menonkrishna57/model-car-capstone/docs/reports/screenshots/screenshot_intermediate_cv_steps.jpg

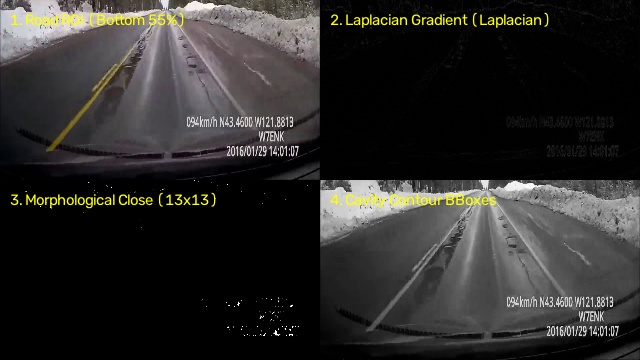
docs/reports/screenshots/screenshot_intermediate_cv_steps.jpg
