menonkrishna57/model-car-capstone/docs/reports/screenshots/slide07_pothole_corridor_frame.jpg

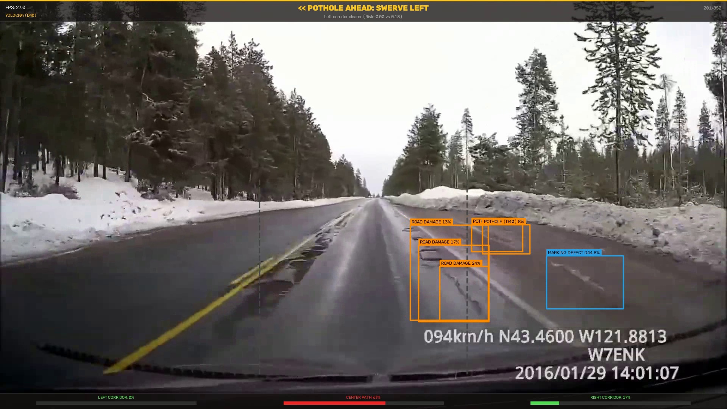
docs/reports/screenshots/slide07_pothole_corridor_frame.jpg
