menonkrishna57/model-car-capstone/docs/architecture.md

# System Architecture — Autonomous Follow-Me and Obstacle-Avoidant RC Vehicle

**Status:** APPROVED / PRODUCTION BASELINE (Architecture v2 — Verified Hardware Baseline)  
**Last Updated:** 2026-10-11  
**Target Hardware:** Raspberry Pi 5 (8GB) + Arduino Uno R3 (ATmega328P)  
**Primary Repositories:** `model-car-capstone` / `MentorPi`  
**Active Branch:** `pothole-detection` / `main`

---

## Executive Summary

This document specifies the canonical system architecture for the autonomous, two-layer robotic model car developed for the B.Tech Capstone Project. The vehicle operates in two distinct operational regimes:
1. **Autonomous Navigation Mode:** Cruising, dynamic obstacle avoidance, and camera-based negative obstacle (pothole/cavity) evasion.
2. **Follow-Me Mode:** Target-locking, real-time person tracking via visual servoing, HSV appearance-based re-identification, and reflexive collision prevention.

To overcome the fundamental failure modes of monolithic, single-board robotics systems—namely Linux kernel preemption, software GPIO PWM jitter, and brownout vulnerability under heavy deep learning workloads—the architecture strictly partitions tasks into a **Cognitive High-Level Brain** (Raspberry Pi 5) and a **Reflexive Hard Real-Time Spine** (Arduino Uno ATmega328P).

```
+---------------------------------------------------------------------------------------+
|                                    SYSTEM TOPOLOGY                                    |
+---------------------------------------------------------------------------------------+
|                                                                                       |
|   +----------------------------------+             +------------------------------+   |
|   |   Raspberry Pi 5 (High-Level)    |             |  Arduino Uno (Real-Time)     |   |
|   |----------------------------------|             |------------------------------|   |
|   | • CSI Camera (OV5647 5MP)        |  USB-Serial | • Hardware Timer0 PWM (D5/D6)|   |
|   | • YOLOv10n (NCNN NMS-Free)       | 115200 Baud | • 3-Tier Priority FSM        |   |
|   | • RDD2022 Pothole YOLO / CV      |    8-N-1    | • 2x HC-SR04P (D7/13, D12/4) |   |
|   | • HSV Appearance Re-ID Tracker   |<----------->| • L298N Skid-Steer (Inverted)|   |
|   | • Discrete PID Steering Engine   |             | • Auto-Brake (<25cm Reflex)  |   |
|   |                                  |             | • Serial Halt ('s'/'g' Pause)|   |
|   +----------------------------------+             +------------------------------+   |
|                    ^                                               ^                  |
|                    | Dedicated 5.1V/5A                             | 7.4V (2S 18650)  |
|   +----------------------------------+             +---------------+--------------+   |
|   | boAt EnergyShroom PB400 Battery  |             | 2S 18650 Li-Ion + Common GND |   |
|   +----------------------------------+             +------------------------------+   |
|                                                                                       |
+---------------------------------------------------------------------------------------+
```

---

## 1. Architectural Philosophy & The Two-Layer Split

### 1.1 The Single-Board Failure Mode (The Linux OS Problem)
Conventional edge AI mobile robots (e.g., NVIDIA JetBot, DonkeyCar) run both high-level neural inference and low-level motor pulsing on a single Linux system-on-chip. This design suffers from three critical failure modes:
1. **Software PWM Timing Jitter:** The Linux Completely Fair Scheduler (CFS) provides no deterministic real-time execution guarantees. Under heavy neural inference (such as YOLOv10 or MobileNet), CPU interrupt latency surges from $<50\,\mu\text{s}$ to $>30\,\text{ms}$. Pulses generated across software GPIO pins jitter violently, causing motor shudder, differential wheel slip, and erratic skid-steer heading errors.
2. **Safety Reflex Preemption:** When an obstacle appears within $15\,\text{cm}$, a single-board architecture must process the image frame, run bounding box prediction, score threat zones, and issue GPIO signals. This pipeline introduces $60\text{–}120\,\text{ms}$ of latency. At a cruising speed of $1.5\,\text{m/s}$, the chassis moves $18\,\text{cm}$ before braking initiates, guaranteeing a physical collision.
3. **OS Crash / Hang Vulnerability:** In the event of a Linux kernel panic, out-of-memory (OOM) freeze, or Python process crash, GPIO pins latch in their last active logic state. A car driving forward will continue driving at full speed into walls, stairs, or human bystanders.

### 1.2 The Two-Layer Solution
Our architecture enforces strict physical and functional isolation:

| Engineering Parameter | Single-Board Architecture (JetBot / DonkeyCar) | Our Two-Layer Architecture (Pi 5 + Arduino Uno) |
|---|---|---|
| **Motor PWM Generation** | Software GPIO (jittery under load, $\pm 25\,\text{ms}$) | Hardware 8-bit Timer0/Timer1/Timer2 (rock-solid, $< 4\,\mu\text{s}$) |
| **Ultrasonic Echo Timing** | User-space polling (unreliable, pulse truncation) | Dedicated microcontroller `pulseIn()` timing ($1\,\mu\text{s}$ precision) |
| **Emergency Reflex Loop** | Soft real-time (60–120 ms round trip) | Hard real-time Tier 2 reflex ($< 10\,\text{ms}$ autonomous trigger) |
| **Crash Protection** | Motors latch at previous state on crash | Hardware Watchdog halts all motors if Pi heartbeat lost ($> 5000\,\text{ms}$, configurable) |
| **Electrical Stability** | Motor back-EMF couples directly into SBC power rail | Dual-rail supplies with common signal ground eliminate brownout resets |
| **BOM Cost** | $\$250\text{–}\$350$ (expensive single boards / carrier kits) | $\sim \$120\text{–}\$150$ (accessible, modular academic components) |

---

## 2. Hardware Architecture & Electrical Design

### 2.1 Complete Pin Mapping Matrix
> **Hardware Status: ARCHITECTURE V2 VERIFIED & BENCH TESTED (2026-10-11).**  
> Complete physical pin tracing, ultrasonic transceiver mapping, motor polarity inversion correction, and TT motor PWM torque compensation have been verified on the physical chassis.

Authoritative pin definitions are maintained in [`arduino/lib/pins.h`](../arduino/lib/pins.h):

| Arduino Uno Pin | Direction | Assigned Function | Connected Hardware Subsystem | Hardware Timer / Characteristics |
|:---:|:---:|---|---|---|
| **D2** | UNCONNECTED | *Reserved / Unused* | Physically Empty | Available for wheel encoder / `INT0` |
| **D3** | UNCONNECTED | *Reserved / Unused* | Physically Empty | Available for wheel encoder / `INT1` |
| **D4** | INPUT | **Right Ultrasonic Echo** | HC-SR04P Front-Right Sensor | $1\,\mu\text{s}$ pulse timing input (`pulseIn`) |
| **D5** | OUTPUT | **ENA (Left Motor PWM)** | L298N Dual H-Bridge Channel A | **Timer0 (OC0B)** — 8-bit PWM (0–255, 980 Hz) |
| **D6** | OUTPUT | **ENB (Right Motor PWM)** | L298N Dual H-Bridge Channel B | **Timer0 (OC0A)** — 8-bit PWM (0–255, 980 Hz) |
| **D7** | OUTPUT | **Left Ultrasonic Trigger** | HC-SR04P Front-Left Sensor | $10\,\mu\text{s}$ digital trigger pulse output |
| **D8** | OUTPUT | **Motor IN1 (Left Dir 1)** | L298N Dual H-Bridge Channel A | Direction bit 1 (Firmware inverted) |
| **D9** | OUTPUT | **Motor IN2 (Left Dir 2)** | L298N Dual H-Bridge Channel A | Direction bit 2 (Firmware inverted) |
| **D10** | OUTPUT | **Motor IN3 (Right Dir 1)**| L298N Dual H-Bridge Channel B | Direction bit 1 (Firmware inverted) |
| **D11** | OUTPUT | **Motor IN4 (Right Dir 2)**| L298N Dual H-Bridge Channel B | Direction bit 2 (Firmware inverted) |
| **D12** | OUTPUT | **Right Ultrasonic Trigger**| HC-SR04P Front-Right Sensor | $10\,\mu\text{s}$ digital trigger pulse output |
| **D13** | INPUT | **Left Ultrasonic Echo** | HC-SR04P Front-Left Sensor | $1\,\mu\text{s}$ pulse timing (Uno 'L' LED flicker is purely cosmetic) |

#### 2.1.1 The Ultrasonic Pin Resolution & Phantom IR Removal
Initial documentation and legacy sketch comments incorrectly assumed pins D2 and D3 were connected to digital IR obstacle sensors, while reversing ultrasonic sensor channel mappings. Physical signal tracing and diagnostic bench testing confirmed:
1. **Pins D2 and D3 are physically empty** on the chassis. No IR sensors are installed on the chassis; D2 and D3 are designated as unreserved inputs, preserving them for future quadrature wheel encoders or external hardware interrupts.
2. The real physical pin routing is verified as:
   * **Left Ultrasonic Sensor:** Trigger = **D7**, Echo = **D13**
   * **Right Ultrasonic Sensor:** Trigger = **D12**, Echo = **D4**
3. **Pin D13 Characteristics:** On the Arduino Uno, pin D13 is internally tied via an op-amp/resistor circuit to the onboard 'L' surface-mount LED. When the Left Ultrasonic emits an echo pulse, the LED flickers faintly. This is cosmetic only and introduces zero signal distortion or timing inaccuracy to `pulseIn()` timing.
4. Live simultaneous centimeter distance telemetry streaming was bench-validated from both ultrasonic transceivers at 115200 baud.

#### 2.1.2 Motor Wiring Polarity & Direction Inversion
Due to physical chassis mounting orientations, the 4WD TT gearbox DC motors were wired with inverted polarity relative to standard H-bridge logic (asserting `IN1=HIGH, IN2=LOW` drove the chassis in reverse). Under the project's strict hard constraint (borrowed lab hardware under shared ID rotation; no cutting or desoldering), physical rewiring was rejected.

This was resolved cleanly at the firmware layer via `#define INVERT_MOTOR_POLARITY true` in [`arduino/lib/pins.h`](../arduino/lib/pins.h) and `const bool INVERT_DIR = true;` in sketch files. The motor driver routines invert speed sign (`s = -s`) prior to setting `IN1`–`IN4`, ensuring all high-level forward drive commands spin the wheels forward.

#### 2.1.3 TT Motor Torque & L298N Voltage Drop Calibration
The L298N dual H-bridge motor driver employs internal bipolar Darlington transistors ($V_{CE(\text{sat})} \approx 1.8\text{–}2.0\,\text{V}$ total drop across high-side and low-side transistors). When powered by a 2S 18650 Li-Ion battery pack ($7.4\,\text{V}$ nominal, $8.4\,\text{V}$ peak), the effective motor terminal voltage is only:
$$V_{\text{motor}} = V_{\text{battery}} - V_{\text{drop}} \approx 7.4\,\text{V} - 2.0\,\text{V} = 5.4\,\text{V}$$

The legacy default PWM speed value of $120$ ($\approx 47\%$ duty cycle) delivered an effective RMS voltage of $\sim 2.5\,\text{V}$, resulting in severe motor stall under the chassis curb weight and floor friction. Torque has been systematically calibrated and empirically verified on the chassis:
* **Forward Cruising (`SPEED_FORWARD`):** PWM **`200`** ($\sim 78\%$ duty cycle, $\sim 4.2\,\text{V}$ RMS)
* **Pivot Skid-Turn (`SPEED_TURN`):** PWM **`210`** ($\sim 82\%$ duty cycle, delivers robust breakaway torque for zero-radius turns)
* **Reverse Clearance (`SPEED_REVERSE`):** PWM **`190`** ($\sim 75\%$ duty cycle)

### 2.2 Dual-Rail Power Distribution (Common Ground Reference)
To prevent inductive motor back-EMF and switching transients from triggering Raspberry Pi brownouts, the power system is partitioned into two physically isolated rails:

```
  MOTOR & ARDUINO RAIL (Common Ground)               PI 5 RAIL (Dedicated boAt PB400)
  ====================================               ====================

  +-------------------------------+                 +-----------------------------------+
  | 2S 18650 Li-Ion Battery Pack  |                 | boAt EnergyShroom PB400 Powerbank |
  |   7.4V Nominal (1500-2500mAh) |                 |   USB-C 5.1V / 5.0A Output        |
  +---------------+---------------+                 +-----------------+-----------------+
                  |                                                   |
                  |                                                   v
                  |                                 +-----------------+-----------------+
                  |                                 | Raspberry Pi 5 (8GB)              |
                  |                                 | Broadcom BCM2712 Quad-Core A76    |
                  |                                 +-----------------+-----------------+
                  |                                                   |
                  v                                                   | USB-A to USB-B
           +------+------+                                            | Serial Cable
           |    L298N    |                                            | (Data + Common GND)
           |    Motor    |<-------------------------------------------+
           |    Driver   |
           +---+----+----+
               |    |
      7.4V VMS |    | Logic 5V / Common GND
               v    v
         +-----+----+----+
         |  Arduino Uno  |
         |  ATmega328P   |
         +-------+-------+
                 |
                 v
         +-------+-------+
         | 16-Pin Berg   |
         | Strip Header  |
         +-------+-------+
                 |
         +-------+-------+
         |               |
         v               v
     4x TT DC        2x HC-SR04P
      Motors          Ultrasonics
   (Skid-Steer)      (Front Array)
```

* **Common Ground Principle:** The motor power rail (2S 18650 negative terminal, L298N GND, and Arduino GND) shares a single ground reference with the Raspberry Pi 5 exclusively through the shielded USB-Serial cable. This preserves 5V logic signal integrity while completely isolating high-current inductive motor spikes from the Pi's sensitive power rail.
* **16-Pin Berg Strip Header:** Provides organized distribution of the regulated 5V bus and ground reference:
  * Pins 1–8: Common +5V Rail (Arduino 5V output, 2x HC-SR04P VCC, L298N logic VCC, spare headers).
  * Pins 9–16: Common GND Rail (Arduino GND, 2x HC-SR04P GND, L298N logic GND, spare headers).

### 2.3 Sensor Array & Spatial Field-of-View (FOV)
The chassis mounts an overlapping multi-sensor array:

```
                          FRONT OF CHASSIS
               ______________________________________
              |                                      |
              |   [US1: Left]          [US2: Right]  |
              |   (Trig D7,            (Trig D12,    |
              |    Echo D13)            Echo D4)     |
              |      \                    /          |   US1: 15° Left Divergence
              |       \   Forward Cone   /           |   US2: 15° Right Divergence
              |        \   Overlapping  /            |   Combined Cone: ~60°
              |         \              /             |   Threshold: < 25.0 cm (Auto-Brake)
              |          \            /              |   Debounce: 2 Confirm Reads
              |           \          /               |
              |            \        /                |
              |             \      /                 |
              |               [CAM]                  |   CAM: CSI Camera (OV5647, ~54° HFOV)
              |               (CSI)                  |   (D2/D3 empty; no IR sensors)
              |                                      |
              |  [FL Wheel]          [FR Wheel]      |   Skid-Steer TT DC Motors
              |  [RL Wheel]          [RR Wheel]      |   Left Pair: ENA(D5) / IN1(D8) / IN2(D9)
              |______________________________________|   Right Pair: ENB(D6) / IN3(D10) / IN4(D11)

                          REAR OF CHASSIS
```

* **HC-SR04P Ultrasonic Transceivers (x2):** Splayed laterally by $15^\circ$ to cover corner obstacles. Effective ranging: $2\,\text{cm}$ to $300\,\text{cm}$. The reflex auto-brake threshold is calibrated at **$25.0\,\text{cm}$** (`OBSTACLE_CM = 25`) with a 2-sample consecutive debounce filter (`CONFIRM_READS = 2`) across $60\,\text{ms}$ loop cycles to suppress acoustic multipath spikes.
* **CSI Monocular Camera (OmniVision OV5647 5MP Rev 1.3):** Replaces the damaged Global Shutter camera, interfacing via a 22-pin to 15-pin FPC adapter cable. Features a $53.5^\circ$ horizontal FOV ($3.6\,\text{mm}$ focal length, $1/4''$ sensor). Mounted $12\,\text{cm}$ above the ground plane, angled downwards at $15^\circ$ pitch to cover both horizon targets and road surface ($0.3\text{–}4.0\,\text{m}$). Diagnostic testing is supported via the local low-latency MJPEG streaming utility ([`tools/stream.py`](../tools/stream.py)).
* **Sensor Blind Spot Coverage:** Horizontal ultrasonic sensors cannot detect road depressions or potholes. Conversely, monocular vision struggles with transparent glass or untextured surfaces at $<10\,\text{cm}$. The multi-modal sensor fusion completely eliminates mutual blind spots.

---

## 3. Firmware Architecture & 3-Tier Reflex State Machine

The Arduino Uno firmware executes a deterministic, non-blocking finite state machine at a calibrated loop rate. The verified diagnostic sketch ([`arduino/motor_test/dual_motor_speed_test.ino`](../arduino/motor_test/dual_motor_speed_test.ino)) and production firmware ([`arduino/point_to_point_control/point_to_point_control.ino`](../arduino/point_to_point_control/point_to_point_control.ino)) implement the 3-tier priority hierarchy:

```mermaid
stateDiagram-v2
    [*] --> STATE_IDLE : Power On / [TELEM] READY

    STATE_IDLE --> STATE_DRIVING : DRIVE cmd / 'g' Resume
    STATE_IDLE --> STATE_TURNING : TURN cmd
    STATE_IDLE --> STATE_REVERSING : REV cmd

    STATE_DRIVING --> STATE_IDLE : Timer Expires / [TELEM] DONE DRIVE
    STATE_TURNING --> STATE_IDLE : Timer Expires / [TELEM] DONE TURN
    STATE_REVERSING --> STATE_IDLE : Timer Expires / [TELEM] DONE REV

    STATE_DRIVING --> STATE_AVOIDING : US reading < 25cm (Tier 2 Reflex)
    STATE_TURNING --> STATE_AVOIDING : US reading < 25cm (Tier 2 Reflex)
    STATE_REVERSING --> STATE_AVOIDING : US reading < 25cm (Tier 2 Reflex)

    STATE_AVOIDING --> STATE_IDLE : Avoidance Sequence Done / [TELEM] DONE AVOID

    STATE_DRIVING --> STATE_PI_STOPPED : PI_STOP / Serial 's' (Tier 1 Latch)
    STATE_TURNING --> STATE_PI_STOPPED : PI_STOP / Serial 's' (Tier 1 Latch)
    STATE_REVERSING --> STATE_PI_STOPPED : PI_STOP / Serial 's' (Tier 1 Latch)
    STATE_AVOIDING --> STATE_PI_STOPPED : PI_STOP / Serial 's' (Tier 1 Latch)
    STATE_IDLE --> STATE_PI_STOPPED : PI_STOP / Serial 's' (Tier 1 Latch)

    STATE_PI_STOPPED --> STATE_IDLE : PI_GO / Serial 'g' (Latch Released)
```

### 3.1 Priority Tiers

#### Tier 1: Emergency Latches, Serial Pause & Watchdog (Absolute Highest Priority)
* **`PI_STOP` / Serial Emergency Halt (`'s'`):** Instantaneous latch. Forces `ENA=0`, `ENB=0` (`stopAll()`), and transitions to `STATE_PI_STOPPED` (or `isStopped = true`). All ongoing actions (including mid-maneuver Tier 2 avoidance) are aborted immediately. The vehicle remains locked until a valid release command is received:
  * Over USB-Serial protocol: `PI_GO` command releases the latch to `STATE_IDLE`.
  * Over interactive serial monitor: Sending `'g'` / `'G'` resumes operation.
* **Watchdog Failsafe:** The firmware monitors incoming serial timestamps. If no valid packet is received within $5000\,\text{ms}$ (`WATCHDOG_TIMEOUT_MS`), the car halts all motors and emits `[TELEM] HEARTBEAT_TIMEOUT`.
* **Command Blocking:** Any Tier 3 movement command received during `STATE_PI_STOPPED` is rejected with `[ACK] BLOCKED (PI_STOPPED)`.

#### Tier 2: Hard Real-Time Local Avoidance Reflex (Autonomous Microcontroller Loop)
Triggered autonomously whenever either front ultrasonic sensor reads $< 25.0\,\text{cm}$ (`OBSTACLE_CM = 25`) confirmed over 2 consecutive readings (`CONFIRM_READS = 2`). Operates with zero latency independent of the Raspberry Pi:
1. **Case A: Both Sensors Blocked ($dL < 25\,\text{cm}$ and $dR < 25\,\text{cm}$):**
   * **Phase 1 — Reverse (`REVERSE_MS = 400ms`):** Reverses both motors at PWM 190 (`SPEED_REVERSE`) to clear the collision zone.
   * **Phase 2 — Pivot Turn (`BOTH_TURN_MS = 450ms`):** Evaluates sensor clearance and turns toward the more open side ($dL \ge dR \rightarrow$ Turn Left; $dL < dR \rightarrow$ Turn Right) at PWM 210 (`SPEED_TURN`).
2. **Case B: Right Sensor Blocked Only ($dR < 25\,\text{cm}$):**
   * Immediately executes a fast skid-turn **Left** (`setLeft(-210)`, `setRight(210)`).
3. **Case C: Left Sensor Blocked Only ($dL < 25\,\text{cm}$):**
   * Immediately executes a fast skid-turn **Right** (`setLeft(210)`, `setRight(-210)`).
4. **Case D: Path Clear ($dL \ge 25\,\text{cm}$ and $dR \ge 25\,\text{cm}$):**
   * Drives forward at calibrated speed PWM 200 (`SPEED_FORWARD`).
5. **Phase 3 — Forward Resume & Cooldown:** Resumes forward cruising. Cooldown period ($500\,\text{ms}$) suppresses re-triggering during initial acceleration.
6. **`PI_AVOID` Hint Override:** If the Pi previously provided an avoidance hint (`PI_AVOID LEFT` or `PI_AVOID RIGHT`), that direction strictly overrides the local decision for both-blocked conditions.

#### Tier 3: High-Level Navigation (Supervised by Raspberry Pi)
Executes timed movement primitives calibrated for the 4WD skid-steer chassis:
* `DRIVE <speed> <duration_ms>` (Default cruising speed: PWM 200)
* `REV <speed> <duration_ms>` (Default reverse speed: PWM 190)
* `TURN <angle_deg> <speed>` (Negative angle = Left, Positive angle = Right; speed: PWM 210)
* `STOP` (Non-latched immediate halt to `STATE_IDLE`)

---

## 4. Perception & Computer Vision Architecture

The perception pipeline running on the Raspberry Pi 5 combines deep neural detection, a classical computer vision fallback for road cavities, and an appearance-based person tracker.

```mermaid
graph TD
    CAM["CSI Camera Ingest<br/>(640x480 @ 30 FPS)"] --> PRE["Preprocessing & ROI Extraction<br/>(Bottom 55% Road Plane)"]

    PRE --> YOLO["YOLOv10n (Tencent NCNN)<br/>Positive Obstacles (Cars, People)"]
    PRE --> POTHOLE["RDD2022 Custom YOLO / Classical CV<br/>Negative Obstacles (Potholes, Cracks)"]

    YOLO --> MERGE["Detection Fusion & Zone Spatial Corridors"]
    POTHOLE --> MERGE

    MERGE --> ZONE["Zone Hazard Scorer<br/>(Left, Center, Right)"]
    ZONE --> DEC["Decision Arbiter Matrix"]

    DEC -->|"EMERGENCY DANGER"| PISTOP["PI_STOP (Latch Car)"]
    DEC -->|"DIRECTIONAL SWERVE"| SWERVE["PI_AVOID + Timed TURN"]
    DEC -->|"CLEAR PATH"| FOLLOW["Follow-Me Visual Servoing"]

    FOLLOW --> KCF["KCF Spatial Tracker"]
    FOLLOW --> HSV["HSV Torso Appearance Re-ID"]
    KCF --> PID["Discrete PID Controller"]
    PID --> NAV["Serial Command Stream<br/>(DRIVE / TURN to Arduino)"]
```

### 4.1 Positive Obstacle Detection: YOLOv10n under Tencent NCNN
* **Architecture:** YOLOv10n eliminates the Non-Maximum Suppression (NMS) post-processing bottleneck by incorporating dual-label assignments during training.
* **Inference Engine:** Tencent NCNN framework with ARM Cortex-A76 NEON FP16 vectorization.
* **Target Classes:** Person (Class 0), Bicycle (1), Car (2), Motorcycle (3), Bus (5), Truck (7).
* **Latency Profile:** $\sim 22\text{–}26\,\text{ms}$ on physical Pi 5 hardware (enabling sustained 30+ FPS pipelines).

### 4.2 Negative Obstacle & Pothole Detection: Dual-Path Engine
Negative obstacles are depressions in the road plane that cannot reflect horizontal acoustic waves. Our system provides two complementary detection layers:

#### Path A: Custom RDD2022 YOLOv10n Deep Model (`pothole_detection/`)
* **Training Dataset:** Road Damage Dataset 2022 (RDD2022 India Sub-dataset, Class D40 Pothole).
* **Weights:** [`pothole_detection/best.pt`](../pothole_detection/best.pt) and [`pothole_detection/rdd2022_yolov8n.pt`](../pothole_detection/rdd2022_yolov8n.pt).
* **Dynamic Corridor & Directional Swerve Module:** Implemented in [`pothole_detection/run_detection.py`](../pothole_detection/run_detection.py):
  * Trapezoidal Perspective ROI isolates the active driving corridor.
  * Zone partitioning: Left Zone ($< 33\%$), Center Danger Corridor ($33\%\text{–}67\%$), Right Zone ($> 67\%$).
  * Automated swerve trajectory selection (`SWERVE_LEFT`, `SWERVE_RIGHT`, `EMERGENCY_STOP`).

#### Path B: Classical Computer Vision Fallback (`cv_detect_potholes`)
Implemented in [`car/perception/detector.py`](../car/perception/detector.py) and [`pothole_detection/negative_obstacle_detection/detector.py`](../pothole_detection/negative_obstacle_detection/detector.py). Runs in $<4\,\text{ms}$ with zero GPU/NPU dependency:
1. **ROI Cropping:** Extracts bottom 55% of the frame (`roi_y = int(h * 0.45)`).
2. **Gaussian Pre-Filtering:** $5\times 5$ Gaussian kernel suppresses high-frequency asphalt noise.
3. **Laplacian Edge Extraction:** Computes second-order spatial derivatives (`cv2.Laplacian(blur, cv2.CV_64F)`). Sharp intensity changes at cavity boundaries yield high response magnitudes.
4. **Morphological Elliptical Structuring:** Applies morphological closing followed by opening with a $13\times 13$ elliptical structuring element (`cv2.MORPH_ELLIPSE`) to solidify cavity regions while rejecting linear surface cracks.
5. **Contour Geometry Screening:**
   * Reject if $\text{Area} < 900\,\text{px}$ (small surface debris).
   * Reject if $\text{Area} > 0.25 \times \text{ROI Area}$ (broad shadows or lighting gradients).
   * Reject if aspect ratio $\text{Width}/\text{Height} \notin [0.25, 5.0]$.

### 4.3 Hazard Zone Danger Scoring
In [`car/perception/avoidance.py`](../car/perception/avoidance.py), bounding boxes are transformed into localized danger scores:

$$\text{Danger} = \text{Confidence} \times W \times \left(0.4 + \min\left(\frac{\text{Area}_{\text{box}}}{\text{Area}_{\text{frame}}}, 0.5\right)\right)$$

* $W = 1.0$ for standard positive obstacles.
* $W = 1.2\text{ to }2.0$ (`POTHOLE_WEIGHT`) for negative obstacles, reflecting the severe hazard of chassis drop-off and high-centering.

### 4.4 Follow-Me Person Tracking & Appearance Re-Identification
Implemented in [`car/perception/tracker.py`](../car/perception/tracker.py):
* **Tracking Subsystem:** OpenCV Kernelized Correlation Filter (KCF) for high-speed frame-to-frame bounding box tracking ($> 60\,\text{FPS}$).
* **HSV Torso Appearance Model:** On initial target lock, a normalized 2D HSV color histogram ($H \times S$, $30 \times 32$ bins) is computed from the upper-torso region of the target bounding box.
* **Re-Acquisition Engine:** If KCF tracking confidence drops below threshold (e.g., target occluded behind a pillar or walked out of frame during sharp pivot):
  1. Car halts motion (`PI_STOP`) to stabilize the camera feed.
  2. YOLOv10n scans all candidates in frame.
  3. The re-ID module evaluates candidate histograms using Bhattacharyya distance:
     $$d(H_1, H_2) = \sqrt{1 - \sum_i \frac{\sqrt{H_1(i) \cdot H_2(i)}}{\sqrt{\sum H_1 \cdot \sum H_2}}}$$
  4. The candidate with the highest similarity exceeding the re-ID threshold is re-locked as the target owner.
* **Discrete PID Visual Servoing:** [`car/control/pid.py`](../car/control/pid.py) modulates steering angle and motor PWM to maintain a $1.2\,\text{m}$ standoff distance:
  * Steering error: Horizontal offset of bounding box center from frame centerline.
  * Distance error: Deviation of bounding box height from calibrated $30\%$ frame height baseline.

---

## 5. Serial Telemetry & Command Protocol

**Authoritative Specification:** [`arduino/PROTOCOL.md`](../arduino/PROTOCOL.md)  
* **Transport:** USB-Serial CDC (`/dev/ttyUSB0` or `/dev/ttyACM0`)  
* **Baud Rate:** `115200 bps`, 8 data bits, no parity, 1 stop bit (`8-N-1`)  
* **Framing:** Plaintext ASCII terminated with newline (`\n`)  
* **Round-Trip Latency:** $\sim 1.2\,\text{ms}$ transaction time

### 5.1 Command Set (Raspberry Pi $\rightarrow$ Arduino)

| Command | Syntax | Parameters | Tier | Functional Description |
|---|---|---|:---:|---|
| **PI_STOP** | `PI_STOP` | None | 1 | Latches vehicle in `STATE_PI_STOPPED`. Forces $PWM=0$. Overrides all states. |
| **PI_GO** | `PI_GO` | None | 1 | Releases `PI_STOP` latch. Returns car to `STATE_IDLE`. |
| **PI_AVOID** | `PI_AVOID <dir>` | `LEFT` or `RIGHT` | 1 | Stores one-shot direction hint for the next Tier 2 reflex avoidance. |
| **'s' / 'S'** | `s` | Single char | 1 | Interactive emergency halt: immediately zeroes all motor outputs. |
| **'g' / 'G'** | `g` | Single char | 1 | Interactive resume: unpauses car and resumes sensor-driven execution. |
| **DRIVE** | `DRIVE <spd> <ms>` | `spd`: 0–255, `ms`: Duration | 3 | Drives forward at PWM speed for specified duration, then halts to `IDLE`. |
| **REV** | `REV <spd> <ms>` | `spd`: 0–255, `ms`: Duration | 3 | Reverses at PWM speed for specified duration, then halts to `IDLE`. |
| **TURN** | `TURN <deg> <spd>` | `deg`: -180 to +180, `spd`: PWM | 3 | Skid-steer turn by angle ($<0$ Left, $>0$ Right) at specified PWM speed. |
| **STOP** | `STOP` | None | 3 | Immediate non-latched halt to `STATE_IDLE`. |
| **PING** | `PING` | None | 3 | Liveness health check. Returns `[ACK] PONG`. |

### 5.2 Telemetry Packet Set (Arduino $\rightarrow$ Raspberry Pi)

| Message Header | Format Example | Frequency | Functional Description |
|---|---|---|---|
| **[TELEM] READY** | `[TELEM] READY Uno-ATmega328P` | Boot | Emitted upon microcontroller reset and setup completion. |
| **[TELEM] STATE** | `[TELEM] STATE=DRIVING SPEED=200` | On change | Signals FSM state transition and active drive speed. |
| **[TELEM] US** | `[TELEM] US LEFT=24.5 RIGHT=88.2` | Every $100\,\text{ms}$ | Calibrated distance readings from front ultrasonic sensors. |
| **Diagnostic Stream** | `L: 24 cm \| R: 88 cm --> CLEAR: Driving FORWARD` | Loop ($60\,\text{ms}$) | Human-readable telemetry emitted by diagnostic obstacle avoidance firmware. |
| **[TELEM] AVOID** | `[TELEM] AVOID RIGHT` | Event | Emitted when Tier 2 reflex initiates an evasive maneuver. |
| **[TELEM] DONE** | `[TELEM] DONE DRIVE` | Event | Confirms completion of a timed movement primitive. |
| **[ACK]** | `[ACK] DRIVE 200 2000` | Immediate | Confirms syntax validity and acceptance of command. |
| **[ACK] BLOCKED** | `[ACK] BLOCKED (PI_STOPPED)` | Immediate | Emitted when command rejected due to active Tier 1 latch. |

---

## 6. System Scenarios & Behavioral Sequence

The system architecture handles complex real-world conditions through 10 formal behavioral scenarios documented in [`docs/scenarios/`](../docs/scenarios/):

### Scenario 05: Negative Obstacle / Pothole Ahead (Camera Detection & Bypass)
* **Situation:** Vehicle is cruising forward. Both ultrasonic sensors read clear ($>90\,\text{cm}$ because horizontal sound waves fly across ground depressions). The Pi camera detects a pothole $1.5\,\text{m}$ ahead.
* **Message Sequence:**
  1. Pi vision detects road cavity via custom RDD2022 YOLO or classical CV.
  2. Pi sends `PI_STOP` $\rightarrow$ Arduino immediately halts motors ($PWM=0$) and acknowledges `[ACK] PI_STOP`.
  3. Pi analyzes Left vs. Right clearance in frame, determining Left is clear.
  4. Pi sends `PI_AVOID LEFT` hint (stored in Arduino memory).
  5. Pi sends `PI_GO` $\rightarrow$ Arduino releases emergency latch to `STATE_IDLE`.
  6. Pi executes bypass sequence: `TURN -60 150` (steer left), waits for `[TELEM] DONE TURN`, sends `DRIVE 150 2000` (clear hole), sends `TURN 60 150` (straighten path), and resumes cruising with `DRIVE 180 5000`.

### Scenario 06: PI_STOP Preemption During Tier 2 Reflex Avoidance
* **Situation:** The car is in the middle of an autonomous Tier 2 ultrasonic evasive maneuver (skid-turning away from a wall) when the Pi camera detects an approaching human or dynamic vehicle in the new heading.
* **Resolution:** `PI_STOP` has absolute priority over Tier 2. The moment `PI_STOP` arrives over serial, the Arduino immediately kills motor PWM, aborts the remaining avoidance phases, and latches into `STATE_PI_STOPPED`. When `PI_GO` is subsequently issued, the car does not resume the aborted avoidance; it enters `STATE_IDLE` with a clean slate.

### Scenario 02: Sudden Physical Obstacle (Tier 2 Ultrasonic Override)
* **Situation:** While executing a high-level `DRIVE` command from the Pi, a low obstacle or reflective surface appears $22\,\text{cm}$ in front of the left sensor (within the calibrated $25\,\text{cm}$ threshold).
* **Resolution:** The Arduino firmware interrupts Tier 3 navigation locally within $10\,\text{ms}$ (debounced across 2 cycles), transitions to `STATE_AVOIDING`, executes an evasive pivot turn right at PWM 210 (or reverses $400\,\text{ms}$ at PWM 190 followed by turn if both sensors trigger), and notifies the Pi with `[TELEM] AVOID RIGHT`.

---

## 7. Comparative Benchmarking Summary

Our architecture has been benchmarked against major open-source mobile robotics frameworks:

| Metric | Our Vehicle (Model-Car) | NVIDIA JetBot | DonkeyCar | OpenBot (Stanford/Intel) |
|---|---|---|---|---|
| **Compute Type** | 2-Layer (Pi 5 + Arduino Uno) | Single-Board (Jetson Nano) | Single-Board (Pi 4 + PCA9685) | 2-Layer (Smartphone + Arduino) |
| **BOM Cost** | **$120–$150 (College Sourced)** | $250–$300 | $250–$300 | $50 Body (Excludes $400+ Phone) |
| **Motor PWM Stability** | Hardware Timer (Zero Jitter) | Linux I2C / Kernel Jitter | I2C PWM Servo Driver | Hardware Timer on Arduino |
| **Detection Stack** | YOLOv10n (NMS-Free) + RDD2022 | MobileNet-SSD / ResNet | Behavioral Cloning CNN | MobileNet-SSD (TFLite) |
| **Pothole / Negative Obstacle** | **Native Deep Model & Laplacian CV** | None (Blind to Potholes) | None | None |
| **Follow-Me Capability** | **KCF + HSV Appearance Re-ID** | None | None | MobileNet Person Tracking |
| **Reflex Fallback** | **Autonomous Hard Real-Time FSM** | None (Vision Only) | None | Sonar on Arduino Body |

---

## 8. Directory & Module Map

```
model-car-capstone/
├── AGENTS.md                                    # Multi-agent roles, constraints, and contracts
├── README.md                                    # Repository overview and getting started
├── arduino/
│   ├── PROTOCOL.md                              # Authoritative serial command/telemetry contract
│   ├── lib/
│   │   ├── pins.h                               # Hardware pin assignments (Architecture v2 single source of truth)
│   │   └── protocol.h                           # Protocol constants, baud, timing thresholds
│   ├── motor_test/
│   │   ├── motor_test.ino                       # Legacy single-motor test (guarded)
│   │   └── dual_motor_speed_test.ino            # Verified working 4WD skid-steer obstacle avoidance & diagnostic suite
│   ├── dual_motor_speed_test/                   # Dedicated standalone Arduino IDE sketch folder
│   │   └── dual_motor_speed_test.ino
│   └── point_to_point_control/
│       ├── point_to_point_control.ino           # Production 3-tier FSM firmware
│       ├── pins.h                               # Local copy for Arduino IDE build compatibility
│       └── protocol.h                           # Local copy for Arduino IDE build compatibility
├── car/
│   ├── main.py                                  # Core perception-decision-actuation loop
│   ├── requirements.txt                         # Runtime dependencies (ultralytics, opencv, pyserial)
│   ├── control/
│   │   ├── motor_controller.py                  # Pi-side serial client and command sender
│   │   ├── navigation.py                        # Dead-reckoning and waypoint driving
│   │   └── pid.py                               # Proportional-Integral-Derivative steering controller
│   └── perception/
│       ├── config.py                            # Model paths, camera resolutions, serial port configs
│       ├── detector.py                          # YOLOv10n NCNN wrapper + classical CV pothole detector
│       ├── avoidance.py                         # Danger zone scoring engine (Left/Center/Right)
│       ├── tracker.py                           # KCF tracker + HSV color appearance re-ID
│       └── sensors.py                           # Serial telemetry parser and ultrasonic tracker
├── pothole_detection/                           # Dedicated Pothole & Road Defect Module
│   ├── CONTEXT.md                               # Pothole detection theory, architecture, and HUD specs
│   ├── run_detection.py                         # Directional swerve & perspective corridor inference engine
│   ├── train_pothole_model.py                   # YOLOv8n fine-tuning pipeline on RDD2022
│   ├── prepare_rdd_yolo.py                      # RDD2022 dataset conversion and augmentation script
│   ├── best.pt / rdd2022_yolov8n.pt             # Fine-tuned model weights (India D40 Pothole class)
│   ├── yolov10n.pt                              # Positive obstacle model weights
│   └── runs_rdd/custom_pothole_model/           # Empirical training metrics (PR/F1 curves, confusion matrix)
├── docs/
│   ├── architecture.md                          # THIS DOCUMENT (Canonical System Architecture)
│   ├── concerns_and_future_todos.md             # Edge-case analysis, calibration roadmap
│   ├── decisions/                               # Architecture Decision Records (ADRs)
│   │   └── 0001-usb-serial-vs-gpio-uart.md
│   ├── reports/                                 # Formal Capstone Benchmarking Reports (DOCX + MD)
│   └── scenarios/                               # 10 formal operational behavioral specifications
│       ├── 01_clear_path.md ... 10_rapid_pi_commands.md
│       └── README.md
└── infra/
    ├── SETUP.md                                 # Headless Pi 5 bringup, interfaces (CSI, I2C, Serial)
    └── pi-image/                                # cloud-init Wi-Fi and headless provisioning configs
```

---

## 9. Architecture Decision Records (ADRs)

### ADR-0001: Transport Selection — USB-Serial vs. GPIO-UART
* **Decision:** Adopt **USB-Serial** (`/dev/ttyUSB0` or `/dev/ttyACM0`) over Raspberry Pi 40-pin GPIO UART (`/dev/ttyAMA0`).
* **Rationale:**
  1. GPIO UART requires disabling the Linux serial login shell and Bluetooth overlay (`dtoverlay=disable-bt`), introducing setup fragility across OS updates.
  2. USB-Serial provides native opto-isolated buffering through the ATmega16U2/CH340 chip, protecting the Pi 5's delicate $3.3\,\text{V}$ unbuffered SoC GPIO pins from $5\,\text{V}$ Arduino logic levels and inductive transients.
  3. Standard USB cables eliminate jumper wire disconnections during chassis road vibration.

### ADR-0002: Perception Inference Engine — Tencent NCNN over ONNX Runtime / PyTorch
* **Decision:** Export YOLO models to **Tencent NCNN** for production Pi 5 execution.
* **Rationale:**
  1. NCNN is explicitly hand-optimized for ARM architectures with assembly-level NEON SIMD vectorization.
  2. NCNN requires zero heavy Python framework dependencies (eliminating PyTorch and TorchScript overhead), drastically reducing memory footprint and boot times.
  3. Eliminates memory fragmentation and thread contention with the camera ingest loop.

### ADR-0003: Microcontroller Evolution — Future Nano Migration
* **Decision:** Design all pin assignments and firmware for compatibility with the **Arduino Nano** (ATmega328P).
* **Rationale:** The Arduino Uno R3 and Arduino Nano share the identical ATmega328P microcontroller core, pin count, register mappings, and hardware timers. Migrating to the Nano in future revisions will reduce chassis footprint by $70\%$ with zero firmware modifications.

### ADR-0004: Hardware Pinout Realignment & IR Sensor Removal
* **Decision:** Re-assign front ultrasonic transceivers to Left = D7 (Trig) / D13 (Echo) and Right = D12 (Trig) / D4 (Echo), designate pins D2 and D3 as UNCONNECTED/RESERVED, and eliminate IR proximity sensors from the physical design.
* **Rationale:**
  1. Physical tracing revealed pins D2 and D3 were completely empty on the physical chassis; phantom code references to IR sensors were legacy artifacts.
  2. Ultrasonic wiring was physically matched to D7/D13 and D12/D4. D13 on Arduino Uno has an onboard LED that flickers during echo pulses, but provides flawless $1\,\mu\text{s}$ timing resolution.
  3. Freeing D2 (`INT0`) and D3 (`INT1`) preserves critical hardware interrupt pins for future rotary wheel encoder integration without requiring breadboard multiplexing.

### ADR-0005: TT Motor Polarity Inversion & L298N BJT Torque Compensation
* **Decision:** Enforce firmware-level direction inversion (`INVERT_MOTOR_POLARITY = true` / `INVERT_DIR = true`) and calibrate operating PWM levels to $190\text{–}210$ (replacing legacy PWM 120/150).
* **Rationale:**
  1. Inverted chassis wiring caused reverse travel on forward logic. Modifying wiring violates the borrowed lab hardware constraint; inverting logic bits in firmware completely solves the problem with zero physical risk.
  2. The L298N's internal bipolar transistors induce a $\approx 2.0\,\text{V}$ drop. From a 2S Li-Ion pack ($7.4\,\text{V}$), only $\sim 5.4\,\text{V}$ reaches the motors. A PWM of 120 provided insufficient torque to break static friction, causing chassis stalls. Operating at PWM 200 (forward) and 210 (pivot turns) delivers reliable breakaway torque and skid-steer maneuvering.

### ADR-0006: Vision Sensor Transition — OmniVision OV5647 5MP Adoption
* **Decision:** Adopt the **OmniVision OV5647 5MP Camera Module (Rev 1.3)** via a 22-pin to 15-pin FPC adapter cable, replacing the cracked Raspberry Pi Global Shutter camera.
* **Rationale:**
  1. Physical glass damage to the borrowed Global Shutter module rendered it non-viable. The OV5647 is widely available, cost-effective, and supported natively by the Raspberry Pi 5 PiSP kernel driver.
  2. The fixed/manual focus lens provides immediate optical sharpness without the heavy blur caused by un-tuned C/CS manual lenses.
  3. The optical horizontal FOV shifts from $120^\circ$ (wide angle) to $\approx 53.5^\circ$ (standard $3.6\,\text{mm}$ lens). Perception and zone-scoring logic in `car/perception/config.py` have been aligned to `CAMERA_HFOV_DEG = 53.5`.
  4. Diagnostic bench viewing is decoupled from high-latency Pi Connect desktop screen-sharing via a dedicated local HTTP MJPEG server ([`tools/stream.py`](../tools/stream.py)). Autonomous driving pipelines bypass streaming entirely, streaming frames in-memory via `picamera2.capture_array()`.
