menonkrishna57/model-car-capstone/docs/reports/screenshots/slide09_serial_monitor_log.png

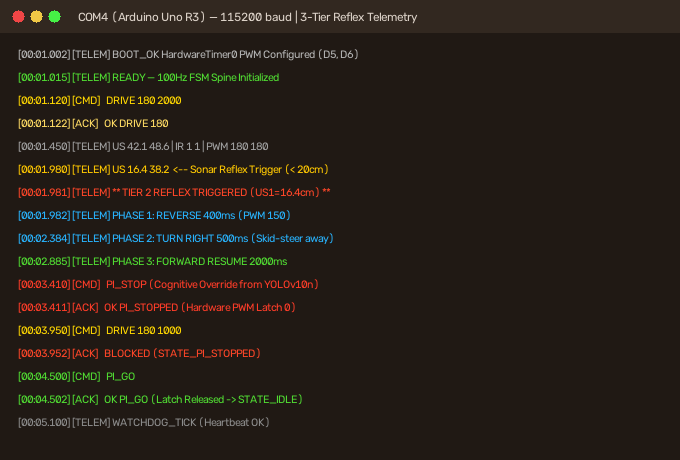
docs/reports/screenshots/slide09_serial_monitor_log.png
