menonkrishna57/model-car-capstone/pothole_detection/runs_rdd/custom_pothole_model/val_batch2_labels.jpg

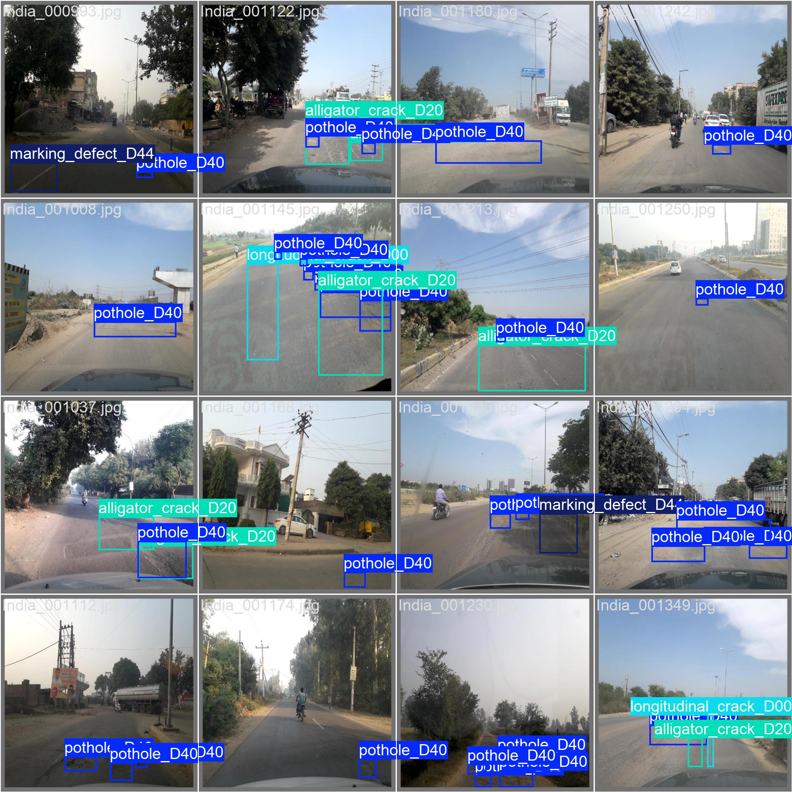
pothole_detection/runs_rdd/custom_pothole_model/val_batch2_labels.jpg
