menonkrishna57/model-car-capstone/pothole_detection/printout_road_clean.jpg

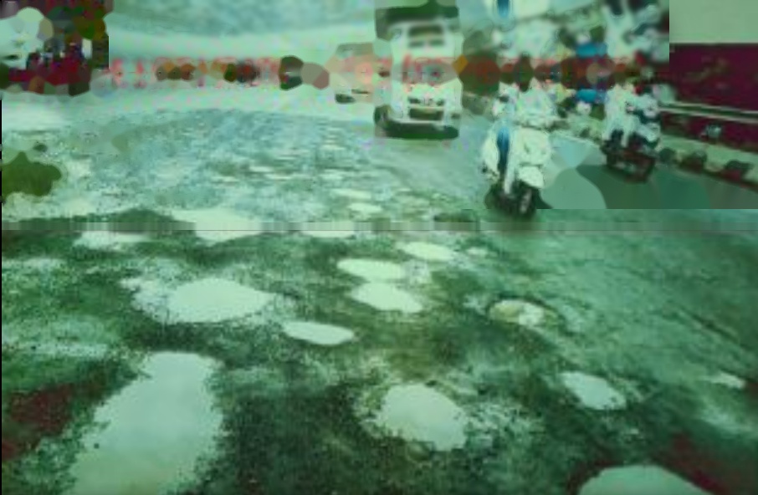
pothole_detection/printout_road_clean.jpg
