menonkrishna57/model-car-capstone/pothole_detection/printout_road_debug.jpg

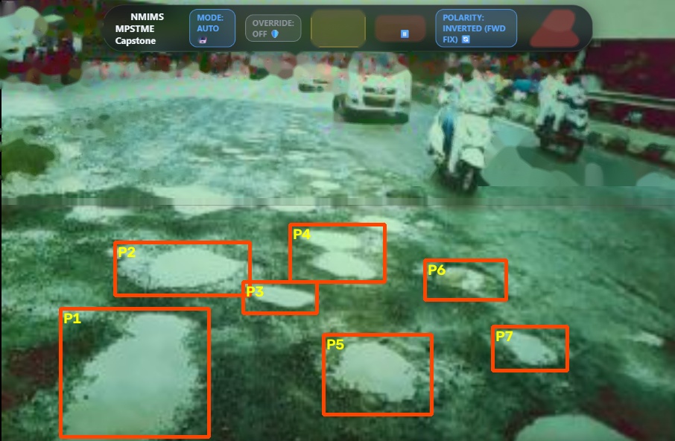
pothole_detection/printout_road_debug.jpg
