menonkrishna57/model-car-capstone/pothole_detection/runs_rdd/printout_gpu_pothole_model/labels.jpg

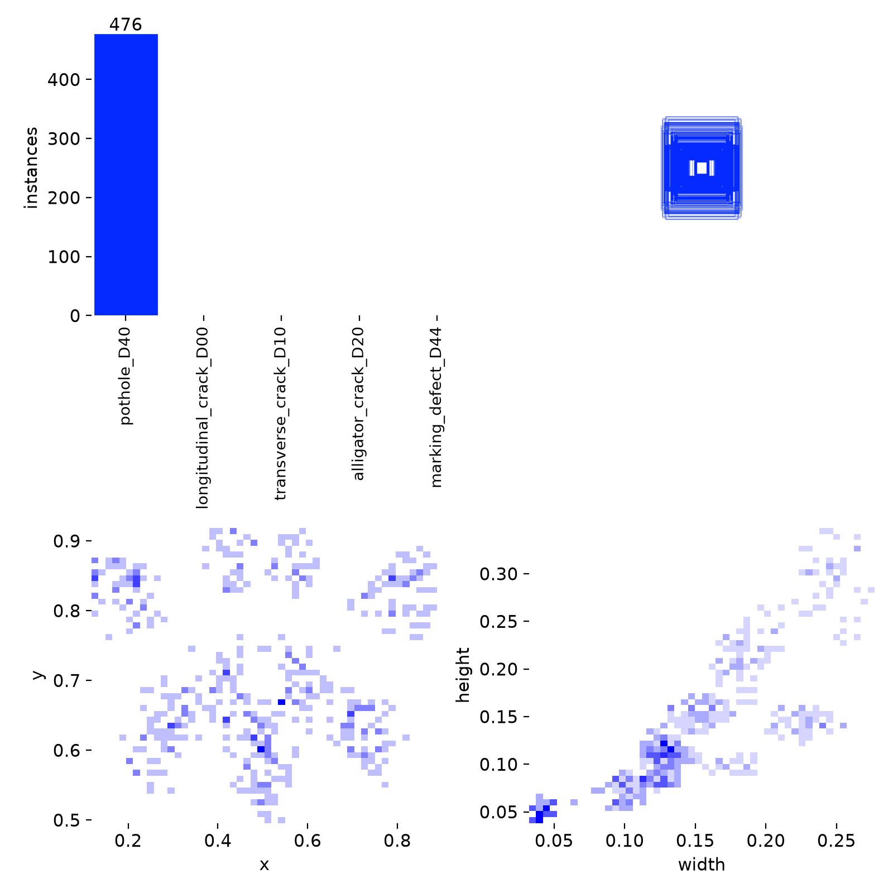
pothole_detection/runs_rdd/printout_gpu_pothole_model/labels.jpg
