menonkrishna57/model-car-capstone/pothole_detection/runs_rdd/printout_gpu_pothole_model/train_batch165.jpg

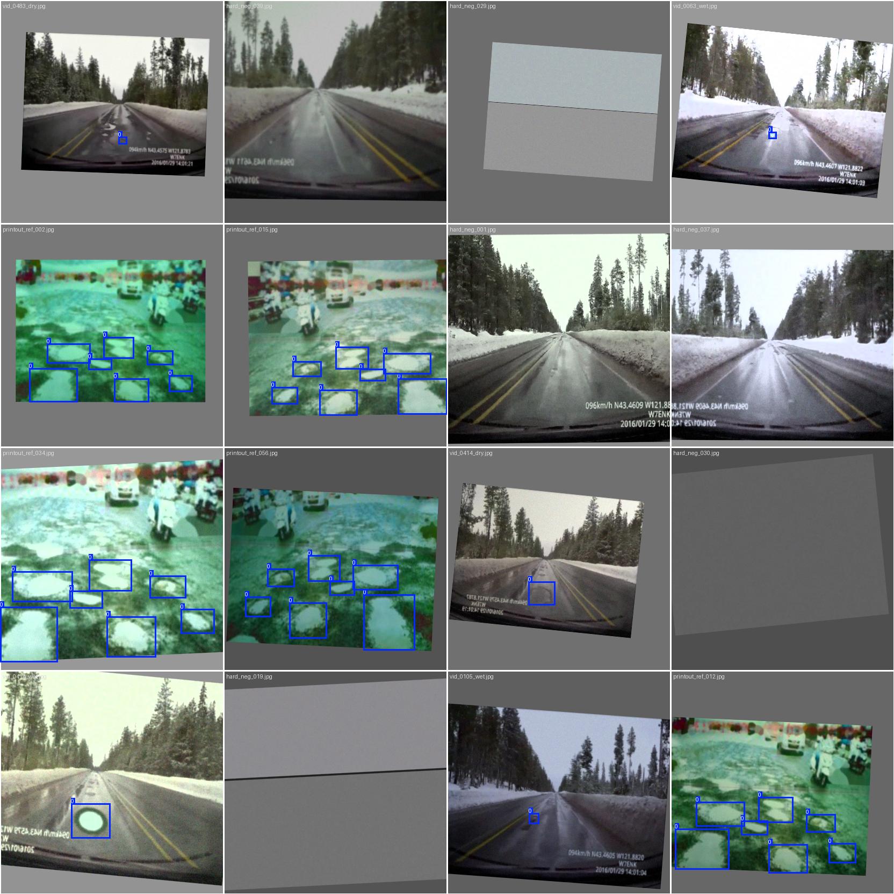
pothole_detection/runs_rdd/printout_gpu_pothole_model/train_batch165.jpg
