menonkrishna57/model-car-capstone/pothole_detection/runs_rdd/printout_gpu_pothole_model/val_batch0_labels.jpg

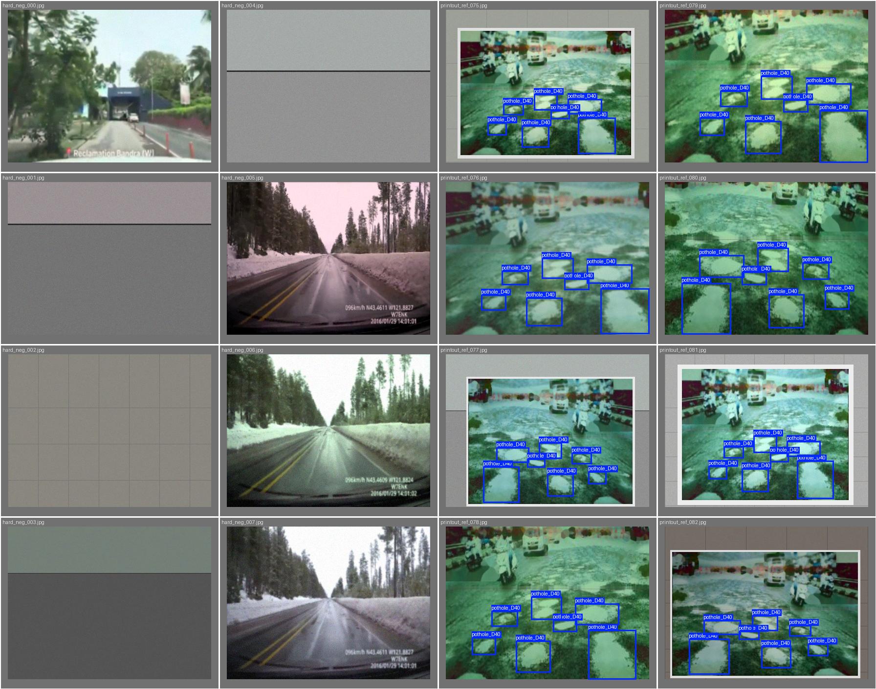
pothole_detection/runs_rdd/printout_gpu_pothole_model/val_batch0_labels.jpg
