menonkrishna57/model-car-capstone/pothole_detection/runs_rdd/printout_gpu_pothole_model/results.csv

epoch | time | train/box_loss | train/cls_loss | train/dfl_loss | metrics/precision(B) | metrics/recall(B) | metrics/mAP50(B) | metrics/mAP50-95(B) | val/box_loss | val/cls_loss | val/dfl_loss | lr/pg0 | lr/pg1 | lr/pg2
1 | 38.8394 | 1.98881 | 3.9248 | 1.6512 | 0.88866 | 0.80899 | 0.9009 | 0.46584 | 1.39809 | 3.4052 | 1.21771 | 0.000366667 | 0.000366667 | 0.0545333
2 | 50.2156 | 1.38616 | 1.4143 | 1.22473 | 0.88411 | 0.89888 | 0.92861 | 0.57847 | 1.2327 | 2.43862 | 1.14357 | 0.000737533 | 0.000737533 | 0.0049042
3 | 63.6613 | 1.2592 | 1.19768 | 1.12772 | 0.9178 | 0.92135 | 0.95691 | 0.59454 | 1.24745 | 1.17975 | 1.10997 | 0.0007392 | 0.0007392 | 0.0007392
4 | 76.2962 | 1.11133 | 0.95921 | 1.05256 | 0.99468 | 0.94382 | 0.96452 | 0.71635 | 0.96754 | 0.74671 | 0.99174 | 0.0007088 | 0.0007088 | 0.0007088
5 | 88.811 | 1.00492 | 0.88081 | 1.02046 | 0.99819 | 0.95506 | 0.96101 | 0.68319 | 1.07797 | 0.74029 | 1.04129 | 0.0006784 | 0.0006784 | 0.0006784
6 | 101.782 | 0.9333 | 0.7582 | 0.98822 | 0.99902 | 0.95506 | 0.97333 | 0.70171 | 0.96129 | 0.61863 | 0.99526 | 0.000648 | 0.000648 | 0.000648
