menonkrishna57/model-car-capstone/tools/presentation/generate_final_presentation.py

"""
Builds the official academic presentation (.pptx) adhering strictly to:
1. Title, course name, names and roll numbers of group members
2. Implementation Pipeline
3. Models and algorithms used
4. Role of models and algorithms used
5. Screen shots of inputs
6. Screen shots of intermediate output, if any
7. Screen shots of output
8. Performance
9. Contribution: Revisions which are not available in literature
10. File name includes roll numbers of group members: CV_mini_project_I028_I045_I062.pptx
"""

import os
import shutil
from pptx import Presentation
from pptx.util import Inches, Pt
from pptx.dml.color import RGBColor
from pptx.enum.shapes import MSO_SHAPE, MSO_CONNECTOR
from pptx.enum.text import PP_ALIGN, MSO_ANCHOR
from pptx.oxml.ns import qn
from lxml import etree

SCREENSHOT_DIR = r"e:\Capstone\model-car-capstone\docs\reports\screenshots"
OUT_ROOT = r"e:\Capstone\model-car-capstone"
OUT_DOCS = r"e:\Capstone\model-car-capstone\docs\reports"
FILE_PRIMARY = "CV_mini_project_I028_I045_I062.pptx"
FILE_SAMPLE = "CV_mini_project_I00x_I00y.pptx"

# ---------------- PALETTE & THEME ----------------
BG = RGBColor(0x0A, 0x11, 0x1E)          # Deep Navy/Dark slate
CARD = RGBColor(0x11, 0x1B, 0x2E)        # Card base
CARD2 = RGBColor(0x18, 0x25, 0x3D)       # Highlight card
CYAN = RGBColor(0x22, 0xD3, 0xEE)        # Primary Accent
AMBER = RGBColor(0xF5, 0x9E, 0x0B)       # Warning / Negative obstacle
GREEN = RGBColor(0x34, 0xD3, 0x99)       # Success / Reflex
RED = RGBColor(0xF8, 0x71, 0x71)         # Emergency / Hazard
VIOLET = RGBColor(0xA7, 0x8B, 0xFA)      # Tracking / Re-ID
TEXT = RGBColor(0xF1, 0xF5, 0xF9)        # Bright Text
MUTED = RGBColor(0x94, 0xA3, 0xB8)       # Secondary / Muted
BORDER = RGBColor(0x2A, 0x3B, 0x55)      # Subtle borders
FONT = "Segoe UI"

prs = Presentation()
prs.slide_width = Inches(13.333)
prs.slide_height = Inches(7.5)
BLANK = prs.slide_layouts[6]
slide_counter = [0]


# ---------------- UTILITY BUILDERS ----------------
def new_slide(title=None, subtitle=None, notes=None):
    s = prs.slides.add_slide(BLANK)
    s.background.fill.solid()
    s.background.fill.fore_color.rgb = BG
    slide_counter[0] += 1
    if title:
        text(s, 0.6, 0.32, 12.0, 0.65, title, 26, TEXT, bold=True)
        bar = s.shapes.add_shape(MSO_SHAPE.RECTANGLE, Inches(0.6), Inches(0.98), Inches(1.3), Inches(0.05))
        fill(bar, CYAN)
        if subtitle:
            text(s, 2.05, 0.88, 10.6, 0.35, subtitle, 12.5, MUTED)
    if slide_counter[0] > 1:
        text(s, 0.6, 7.12, 8.0, 0.3, "CV Mini Project  •  NMIMS MPSTME  •  Model-Car Capstone", 9.5, MUTED)
        text(s, 11.8, 7.12, 1.0, 0.3, f"{slide_counter[0]} / 14", 9.5, MUTED, align=PP_ALIGN.RIGHT)
    if notes:
        s.notes_slide.notes_text_frame.text = notes
    return s


def fill(shape, color, line=None, width=1.0):
    shape.fill.solid()
    shape.fill.fore_color.rgb = color
    if line is None:
        shape.line.fill.background()
    else:
        shape.line.color.rgb = line
        shape.line.width = Pt(width)
    shape.shadow.inherit = False


def text(s, x, y, w, h, content, size=13, color=TEXT, bold=False, align=PP_ALIGN.LEFT,
         anchor=MSO_ANCHOR.TOP, italic=False):
    tb = s.shapes.add_textbox(Inches(x), Inches(y), Inches(w), Inches(h))
    tf = tb.text_frame
    tf.word_wrap = True
    tf.vertical_anchor = anchor
    tf.margin_left = tf.margin_right = tf.margin_top = tf.margin_bottom = Inches(0.04)
    lines = content if isinstance(content, list) else [content]
    for i, ln in enumerate(lines):
        p = tf.paragraphs[0] if i == 0 else tf.add_paragraph()
        p.alignment = align
        r = p.add_run()
        r.text = ln
        r.font.name = FONT
        r.font.size = Pt(size)
        r.font.bold = bold
        r.font.italic = italic
        r.font.color.rgb = color
    return tb


def bullets(s, x, y, w, h, items, size=13, color=TEXT, bullet_color=CYAN, spacing=5):
    tb = s.shapes.add_textbox(Inches(x), Inches(y), Inches(w), Inches(h))
    tf = tb.text_frame
    tf.word_wrap = True
    tf.margin_left = tf.margin_right = tf.margin_top = tf.margin_bottom = Inches(0.04)
    
    # Flatten items if any tuple has a list body
    flat_items = []
    for item in items:
        if isinstance(item, tuple) and isinstance(item[1], list):
            flat_items.append((item[0], ""))
            for sub_i in item[1]:
                flat_items.append(("  •", str(sub_i)))
        else:
            flat_items.append(item)

    for i, item in enumerate(flat_items):
        p = tf.paragraphs[0] if i == 0 else tf.add_paragraph()
        p.space_after = Pt(spacing)
        if isinstance(item, tuple):
            head, body = item
        else:
            head, body = None, str(item)
        b = p.add_run()
        b.text = "▸ " if not (head and head.startswith("  •")) else "    "
        b.font.name = FONT
        b.font.size = Pt(size)
        b.font.color.rgb = bullet_color
        if head:
            r = p.add_run()
            r.text = head + " "
            r.font.name = FONT
            r.font.size = Pt(size)
            r.font.bold = True
            r.font.color.rgb = color
        if body:
            r = p.add_run()
            r.text = str(body)
            r.font.name = FONT
            r.font.size = Pt(size)
            r.font.color.rgb = color
    return tb


def card(s, x, y, w, h, title, lines, accent=CYAN, title_size=15, body_size=12):
    box = s.shapes.add_shape(MSO_SHAPE.ROUNDED_RECTANGLE, Inches(x), Inches(y), Inches(w), Inches(h))
    box.adjustments[0] = 0.05
    fill(box, CARD, line=BORDER)
    strip = s.shapes.add_shape(MSO_SHAPE.RECTANGLE, Inches(x), Inches(y + 0.12), Inches(0.06), Inches(h - 0.24))
    fill(strip, accent)
    text(s, x + 0.2, y + 0.12, w - 0.35, 0.4, title, title_size, accent, bold=True)
    bullets(s, x + 0.2, y + 0.52, w - 0.35, h - 0.6, lines, size=body_size, bullet_color=accent, spacing=3.5)


def node(s, x, y, w, h, title, sub=None, color=CYAN, title_size=11.5, sub_size=9.5):
    box = s.shapes.add_shape(MSO_SHAPE.ROUNDED_RECTANGLE, Inches(x), Inches(y), Inches(w), Inches(h))
    box.adjustments[0] = 0.1
    fill(box, CARD2, line=color, width=1.2)
    tf = box.text_frame
    tf.word_wrap = True
    tf.vertical_anchor = MSO_ANCHOR.MIDDLE
    tf.margin_left = tf.margin_right = tf.margin_top = tf.margin_bottom = Inches(0.05)
    p = tf.paragraphs[0]
    p.alignment = PP_ALIGN.CENTER
    r = p.add_run()
    r.text = title
    r.font.name = FONT
    r.font.size = Pt(title_size)
    r.font.bold = True
    r.font.color.rgb = color
    if sub:
        for ln in sub.split("\n"):
            p2 = tf.add_paragraph()
            p2.alignment = PP_ALIGN.CENTER
            r2 = p2.add_run()
            r2.text = ln
            r2.font.name = FONT
            r2.font.size = Pt(sub_size)
            r2.font.color.rgb = TEXT
    return box


def arrow(s, x1, y1, x2, y2, color=MUTED, width=1.5):
    c = s.shapes.add_connector(MSO_CONNECTOR.STRAIGHT, Inches(x1), Inches(y1), Inches(x2), Inches(y2))
    c.line.color.rgb = color
    c.line.width = Pt(width)
    ln = c.line._get_or_add_ln()
    tail = etree.SubElement(ln, qn("a:tailEnd"))
    tail.set("type", "triangle")
    tail.set("w", "med")
    tail.set("len", "med")
    return c


def table(s, x, y, w, h, rows, col_widths=None, header_color=CYAN, size=10.5, highlight_row=None):
    nr, nc = len(rows), len(rows[0])
    gt = s.shapes.add_table(nr, nc, Inches(x), Inches(y), Inches(w), Inches(h))
    tbl = gt.table
    tblPr = gt._element.graphic.graphicData.tbl.tblPr
    tblPr.set("bandRow", "0")
    tblPr.set("firstRow", "0")
    if col_widths:
        for i, cw in enumerate(col_widths):
            tbl.columns[i].width = Inches(cw)
    for r in range(nr):
        for c in range(nc):
            cell = tbl.cell(r, c)
            cell.fill.solid()
            if r == 0:
                cell.fill.fore_color.rgb = CARD2
            elif highlight_row is not None and r == highlight_row:
                cell.fill.fore_color.rgb = RGBColor(0x0E, 0x36, 0x48)
            else:
                cell.fill.fore_color.rgb = CARD if r % 2 else RGBColor(0x0E, 0x16, 0x26)
            cell.margin_left = cell.margin_right = Inches(0.08)
            cell.vertical_anchor = MSO_ANCHOR.MIDDLE
            tf = cell.text_frame
            tf.word_wrap = True
            p = tf.paragraphs[0]
            p.alignment = PP_ALIGN.CENTER if c > 0 else PP_ALIGN.LEFT
            run = p.add_run()
            run.text = str(rows[r][c])
            run.font.name = FONT
            run.font.size = Pt(size)
            run.font.bold = (r == 0) or (highlight_row is not None and r == highlight_row and c == 0)
            run.font.color.rgb = header_color if r == 0 else TEXT
    return tbl


def image_card(s, x, y, w, h, img_name, title, caption=None, accent=CYAN):
    box = s.shapes.add_shape(MSO_SHAPE.ROUNDED_RECTANGLE, Inches(x), Inches(y), Inches(w), Inches(h))
    box.adjustments[0] = 0.04
    fill(box, CARD, line=accent, width=1.2)
    
    # Title badge
    strip = s.shapes.add_shape(MSO_SHAPE.RECTANGLE, Inches(x + 0.15), Inches(y + 0.12), Inches(0.05), Inches(0.3))
    fill(strip, accent)
    text(s, x + 0.25, y + 0.12, w - 0.4, 0.32, title, 13, accent, bold=True)
    
    # Image
    img_path = os.path.join(SCREENSHOT_DIR, img_name)
    has_img = os.path.exists(img_path)
    img_h = h - 0.75 if caption else h - 0.55
    if has_img:
        s.shapes.add_picture(img_path, Inches(x + 0.15), Inches(y + 0.48), Inches(w - 0.3), Inches(img_h))
    else:
        # Fallback placeholder
        p_box = s.shapes.add_shape(MSO_SHAPE.RECTANGLE, Inches(x + 0.15), Inches(y + 0.48), Inches(w - 0.3), Inches(img_h))
        fill(p_box, CARD2, line=AMBER)
        text(s, x + 0.3, y + 1.2, w - 0.6, 0.8, f"[Image Missing: {img_name}]", 12, AMBER, align=PP_ALIGN.CENTER)
    
    # Caption
    if caption:
        text(s, x + 0.15, y + h - 0.28, w - 0.3, 0.25, caption, 10, MUTED, italic=True)


# =====================================================================
# SLIDE 1 — TITLE & GROUP INFORMATION
# Guideline 1: Title, course name, names and roll numbers of group members
# =====================================================================
s1 = new_slide()
glow = s1.shapes.add_shape(MSO_SHAPE.OVAL, Inches(8.5), Inches(-1.5), Inches(7.5), Inches(7.5))
fill(glow, RGBColor(0x0C, 0x2A, 0x3E))

text(s1, 0.8, 0.9, 11.5, 0.4, "COMPUTER VISION (CV) MINI PROJECT  •  ACADEMIC CAPSTONE 2026", 14, CYAN, bold=True)
text(s1, 0.8, 1.45, 11.8, 1.8,
     ["Autonomous Follow-Me & Obstacle-Avoidant",
      "Robotic Vehicle with Pothole Detection"], 36, TEXT, bold=True)

desc = ("A Two-Layer Heterogeneous Edge Architecture (Raspberry Pi 5 + Arduino Uno) with NMS-Free "
        "YOLOv10n Inference on Tencent NCNN, Dual-Modality Pothole Avoidance, and Multi-Tier Reflex FSM.")
text(s1, 0.8, 3.4, 11.5, 0.75, desc, 14.5, MUTED)

bar1 = s1.shapes.add_shape(MSO_SHAPE.RECTANGLE, Inches(0.8), Inches(4.35), Inches(2.0), Inches(0.06))
fill(bar1, CYAN)

# Group Members Box (Explicit Names & Roll Numbers)
grp_box = s1.shapes.add_shape(MSO_SHAPE.ROUNDED_RECTANGLE, Inches(0.8), Inches(4.6), Inches(11.7), Inches(2.3))
grp_box.adjustments[0] = 0.04
fill(grp_box, CARD, line=CYAN)

text(s1, 1.1, 4.75, 4.5, 0.35, "PROJECT TEAM MEMBERS", 13, CYAN, bold=True)
members = [
    ("Krishna Menon", "Roll No: I028  |  Lead: Hardware, Firmware & System Integration"),
    ("Aditya Rana",  "Roll No: I045  |  Hardware Architecture, Chassis & Benchmarking"),
    ("Parth Surve",  "Roll No: I062  |  Computer Vision Pipeline, Neural Models & Software"),
]
for i, (name, role) in enumerate(members):
    y_pos = 5.15 + i * 0.48
    badge = s1.shapes.add_shape(MSO_SHAPE.ROUNDED_RECTANGLE, Inches(1.1), Inches(y_pos), Inches(0.85), Inches(0.36))
    badge.adjustments[0] = 0.2
    fill(badge, CARD2, line=AMBER)
    text(s1, 1.1, y_pos + 0.05, 0.85, 0.3, f"#{i+1}", 11, AMBER, bold=True, align=PP_ALIGN.CENTER)
    text(s1, 2.1, y_pos, 3.5, 0.35, name, 14, TEXT, bold=True)
    text(s1, 4.6, y_pos + 0.02, 7.5, 0.35, role, 12, MUTED)

text(s1, 1.1, 6.55, 11.0, 0.3, "Department of Electronics & Telecommunication / Computer Engineering  •  NMIMS MPSTME", 11.5, CYAN)


# =====================================================================
# SLIDE 2 — PROBLEM STATEMENT & REAL-WORLD CHALLENGES
# =====================================================================
s2 = new_slide("Problem Statement & Identified Research Gaps",
               "Why monolithic Linux control and acoustic sensors fail in Indian road conditions",
               notes="Detail the 3 key gaps: Linux OS PWM jitter, acoustic blindness to potholes, and high kit costs.")

card(s2, 0.6, 1.45, 3.9, 4.1, "01  Linux OS Scheduling Jitter", [
    ("OS Concurrency:", "Linux Completely Fair Scheduler (CFS) provides zero real-time guarantees."),
    ("PWM Distortion:", "Under heavy neural vision load, GPIO PWM duty cycles jitter severely, causing motor shudder and drift."),
    ("Braking Lag:", "Camera-to-motor latency spikes to 60–120 ms, traveling 10–18 cm before braking, causing collisions."),
], accent=RED, title_size=15, body_size=11.5)

card(s2, 4.72, 1.45, 3.9, 4.1, "02  Acoustic Blindness (Potholes)", [
    ("Horizontal Wave:", "Ultrasonic sensors (HC-SR04P) propagate sound waves parallel to the road surface."),
    ("Zero Backscatter:", "Downward depressions, road cavities, and potholes reflect sound away from the sensor."),
    ("False Clear:", "Reads as infinite clear distance; vehicle drives straight into severe roadway holes."),
], accent=AMBER, title_size=15, body_size=11.5)

card(s2, 8.84, 1.45, 3.9, 4.1, "03  High Cost & Modular Access", [
    ("Commercial Kits:", "Imported kits (JetBot, DeepRacer, MentorPi) cost ₹25,000–₹45,000+ INR in India."),
    ("Monolithic Trap:", "Collapse vision and motors onto one SoC, prone to kernel freezes and motor runaways."),
    ("Academic Goal:", "Design a robust two-layer modular vehicle under ₹8,000 using college lab hardware."),
], accent=GREEN, title_size=15, body_size=11.5)

summary_box = s2.shapes.add_shape(MSO_SHAPE.ROUNDED_RECTANGLE, Inches(0.6), Inches(5.75), Inches(12.14), Inches(1.1))
fill(summary_box, CARD2, line=CYAN)
text(s2, 0.85, 5.85, 11.6, 0.9,
     "Core Engineering Solution: Physically decouple high-level neural perception (Raspberry Pi 5) from hard real-time "
     "reflex control (Arduino Uno ATmega328P Timer0 PWM), fused with a dual-modality computer vision pothole detector.",
     13.5, TEXT, anchor=MSO_ANCHOR.MIDDLE)


# =====================================================================
# SLIDE 3 — IMPLEMENTATION PIPELINE
# Guideline 2: Implementation Pipeline
# =====================================================================
s3 = new_slide("Implementation Pipeline — End-to-End System Architecture",
               "Camera Frame  →  NCNN Inference  →  Corridor Scorer  →  Serial Protocol  →  Reflex FSM  →  Motors",
               notes="Walk through perception pipeline on Pi 5 down through 115200 serial into Arduino Uno reflex FSM.")

# Pi 5 Block Container
pi_box = s3.shapes.add_shape(MSO_SHAPE.ROUNDED_RECTANGLE, Inches(0.4), Inches(1.35), Inches(12.55), Inches(2.65))
pi_box.adjustments[0] = 0.03
fill(pi_box, RGBColor(0x0C, 0x16, 0x2A), line=RGBColor(0x1E, 0x3A, 0x5F), width=1.5)
text(s3, 0.6, 1.42, 4.5, 0.3, "LAYER 1: PERCEPTION & DECISION (Raspberry Pi 5 — Quad Cortex-A76 @ 2.4 GHz)", 10.5, CYAN, bold=True)

node(s3, 0.55, 1.85, 1.6, 1.8, "CSI Camera\n(OV5647)", "640×480 Raw\n30 FPS\nDaylight AWB", color=CYAN, title_size=12, sub_size=10)
arrow(s3, 2.15, 2.75, 2.45, 2.75)

node(s3, 2.45, 1.85, 1.6, 1.8, "Image Ingest\n& Pre-Process", "320×320 Resize\nFP16 Normalise\nBottom 55% ROI", color=CYAN, title_size=12, sub_size=10)
arrow(s3, 4.05, 2.3, 4.35, 2.1)
arrow(s3, 4.05, 3.2, 4.35, 3.4)

node(s3, 4.35, 1.6, 2.1, 1.05, "YOLOv10n NCNN", "Dual-label assign\nNo-NMS on CPU (22ms)", color=GREEN, title_size=11.5, sub_size=9)
node(s3, 4.35, 2.8, 2.1, 1.05, "Pothole Engine", "RDD2022 D40 Model\n+ Laplacian CV Filter", color=AMBER, title_size=11.5, sub_size=9)
arrow(s3, 6.45, 2.1, 6.75, 2.5)
arrow(s3, 6.45, 3.4, 6.75, 2.9)

node(s3, 6.75, 1.85, 1.8, 1.8, "Corridor Risk\nZone Scorer", "Left / Center / Right\nDynamic danger cost\nW_pothole = 1.5", color=VIOLET, title_size=12, sub_size=9.5)
arrow(s3, 8.55, 2.75, 8.85, 2.75)

node(s3, 8.85, 1.85, 1.8, 1.8, "Decision Arbiter\n& Visual Servo", "KCF Target Lock\nHSV Torso Re-ID\nDiscrete PID Steer", color=VIOLET, title_size=12, sub_size=9.5)
arrow(s3, 10.65, 2.75, 10.95, 2.75)

node(s3, 10.95, 1.6, 1.85, 0.65, "PI_STOP", "Emergency Latch", color=RED, title_size=10.5, sub_size=8.5)
node(s3, 10.95, 2.38, 1.85, 0.65, "PI_AVOID L/R", "Corridor Swerve", color=AMBER, title_size=10.5, sub_size=8.5)
node(s3, 10.95, 3.15, 1.85, 0.65, "DRIVE / TURN", "PID Motor Control", color=GREEN, title_size=10.5, sub_size=8.5)

# Serial Bridge
ser_bar = s3.shapes.add_shape(MSO_SHAPE.ROUNDED_RECTANGLE, Inches(0.4), Inches(4.15), Inches(12.55), Inches(0.52))
fill(ser_bar, CARD2, line=CYAN)
text(s3, 0.5, 4.22, 12.35, 0.38,
     "USB-SERIAL BRIDGE (115200 Baud, 8-N-1):  Commands [PI_STOP | PI_AVOID | DRIVE v t | TURN deg]  ⇄  Replies [TELEM us_L us_R | ACK]",
     11, TEXT, bold=True, align=PP_ALIGN.CENTER)

# Arduino Block Container
ar_box = s3.shapes.add_shape(MSO_SHAPE.ROUNDED_RECTANGLE, Inches(0.4), Inches(4.8), Inches(12.55), Inches(2.15))
ar_box.adjustments[0] = 0.04
fill(ar_box, RGBColor(0x0C, 0x16, 0x2A), line=RGBColor(0x1E, 0x4A, 0x3A), width=1.5)
text(s3, 0.6, 4.88, 5.0, 0.3, "LAYER 2: HARD REAL-TIME MOTOR REFLEX (Arduino Uno — ATmega328P @ 16 MHz)", 10.5, GREEN, bold=True)

node(s3, 0.55, 5.25, 2.0, 1.45, "4× TT DC Motors\n& Skid-Steer", "Left: D8, D9 | ENA: D5\nRight: D10, D11 | ENB: D6", color=TEXT, title_size=11.5, sub_size=9.5)
arrow(s3, 2.85, 5.95, 2.55, 5.95)

node(s3, 2.85, 5.25, 2.1, 1.45, "L298N Dual\nH-Bridge Driver", "Hardware Timer0 PWM\nCalibrated Min PWM: 190\nV_ce drop comp: 2.0V", color=TEXT, title_size=11.5, sub_size=9.5)
arrow(s3, 5.25, 5.95, 4.95, 5.95)

node(s3, 5.25, 5.25, 2.2, 1.45, "Tier 3: Trajectory\nExecution", "DRIVE, REV, TURN\nNon-blocking tick loop\nActive command timeout", color=GREEN, title_size=11.5, sub_size=9.5)
arrow(s3, 7.75, 5.95, 7.45, 5.95)

node(s3, 7.75, 5.25, 2.3, 1.45, "Tier 2: Sonar Reflex\n(< 20 cm Avoidance)", "2× HC-SR04P polling\nInstant reverse & pivot\nHardware override", color=AMBER, title_size=11.5, sub_size=9.5)
arrow(s3, 10.35, 5.95, 10.05, 5.95)

node(s3, 10.35, 5.25, 2.45, 1.45, "Tier 1: Emergency\nStop & Watchdog", "Instant PWM=0 freeze\nWatchdog timeout: 1000ms\nLatched until PI_GO", color=RED, title_size=11.5, sub_size=9.5)


# =====================================================================
# SLIDE 4 — MODELS AND ALGORITHMS USED
# Guideline 3: Models and algorithms used
# =====================================================================
s4 = new_slide("Models and Algorithms Used in the System",
               "Mathematical foundations and algorithmic design of the perception and control stack",
               notes="Present all 6 core models/algorithms used across deep learning, classical CV, and control theory.")

card(s4, 0.6, 1.45, 3.9, 2.65, "01  YOLOv10n (Dual-Label Head)", [
    ("Architecture:", "NMS-free lightweight neural detector (2.3M params, 6.7 GFLOPs)."),
    ("Training Trick:", "Dual label assignment (one-to-many for representation + one-to-one for inference)."),
    ("Advantage:", "Completely eliminates CPU Non-Maximum Suppression bottleneck."),
], accent=CYAN, body_size=11)

card(s4, 4.72, 1.45, 3.9, 2.65, "02  RDD2022 Pothole Cavity Model", [
    ("Dataset:", "Road Damage Dataset (RDD2022 India subset, Class D40 potholes)."),
    ("Optimization:", "Trained 50 epochs on cavity geometries; exported to FP16 NCNN."),
    ("Output:", "Bounding box cavity coordinates + confidence score for zone weighting."),
], accent=AMBER, body_size=11)

card(s4, 8.84, 1.45, 3.9, 2.65, "03  Laplacian Edge CV Fallback", [
    ("Mathematical Op:", "Second-order spatial gradient: ∇²f = ∂²f/∂x² + ∂²f/∂y²."),
    ("Filtering:", "Gaussian blur (5×5) → Laplacian kernel → 13×13 elliptical closing."),
    ("Latency:", "Sub-4ms deterministic execution; zero neural hallucination."),
], accent=CYAN, body_size=11)

card(s4, 0.6, 4.25, 3.9, 2.7, "04  KCF Visual Tracker", [
    ("Theory:", "Kernelized Correlation Filters with circulant matrix ridge regression."),
    ("Efficiency:", "Computed in Fourier domain using 2D FFT: f(z) = w^T φ(z)."),
    ("Framerate:", "Operates at >120 FPS on CPU to bridge neural detection gaps."),
], accent=GREEN, body_size=11)

card(s4, 4.72, 4.25, 3.9, 2.7, "05  2D HSV Torso Re-ID Histogram", [
    ("Representation:", "2D Hue-Saturation appearance matrix (30 H-bins × 32 S-bins)."),
    ("Metric:", "Bhattacharyya distance: d(H1, H2) = √(1 - Σ√(H1(i)·H2(i)))."),
    ("Function:", "Re-identifies owner after full occlusion or frame loss (Threshold > 0.60)."),
], accent=VIOLET, body_size=11)

card(s4, 8.84, 4.25, 3.9, 2.7, "06  Discrete PID Steering Servo", [
    ("Equation:", "u(t) = K_p·e(t) + K_i·Σe(t)Δt + K_d·[e(t) - e(t-1)]/Δt."),
    ("Steering Error:", "e_x = (x_target_center - x_frame_center) / frame_width."),
    ("Distance Error:", "e_d = (h_target_box / frame_height) - 0.30 (standoff distance)."),
], accent=GREEN, body_size=11)


# =====================================================================
# SLIDE 5 — ROLE OF MODELS AND ALGORITHMS USED
# Guideline 4: Roll (Role) of models and algorithms used
# =====================================================================
s5 = new_slide("Role of Models and Algorithms Used",
               "Clear allocation of computational responsibilities, hardware hosts, and fail-safes",
               notes="Walk through this matrix to prove every algorithm has a specific role, budget, and backup.")

role_table = [
    ["Model / Algorithm", "Specific Operational Role", "Hardware Host", "Latency Budget", "Fallback Strategy"],
    ["YOLOv10n Neural Model", "Multi-class positive obstacle detection (pedestrians, vehicles, obstacles)", "Pi 5 CPU (4 cores)", "22.4 ms (44.6 FPS)", "KCF tracker hold (5 frames)"],
    ["RDD2022 Pothole Specialist", "Detects negative road depressions (cavities, cracks, open potholes)", "Pi 5 CPU (NCNN)", "18.2 ms (54.9 FPS)", "Classical Laplacian CV detector"],
    ["Classical Laplacian CV", "Ultra-fast roadway texture gradient and cavity contour segmentation", "Pi 5 CPU (OpenCV)", "< 3.8 ms", "Conservative road center bias"],
    ["KCF Visual Tracker", "Maintains target bounding box across frames at ultra-high refresh rate", "Pi 5 CPU", "< 2.5 ms (120+ FPS)", "Full-frame YOLOv10n re-detection"],
    ["2D HSV Re-ID Histogram", "Locks onto owner's upper torso clothing signature to survive occlusion", "Pi 5 RAM / CPU", "< 1.2 ms", "Car halts (PI_STOP); sweeps field"],
    ["Corridor Risk Scorer", "Divides road into 3 zones (L/C/R); computes dynamic collision cost", "Pi 5 Python Engine", "< 0.8 ms", "Tier 2 local ultrasonic reflex"],
    ["Discrete PID Controller", "Smooths steering angles and maintains 0.8m standoff distance", "Pi 5 Control Engine", "< 0.5 ms", "Fixed proportional steering clamp"],
    ["3-Tier Firmware FSM", "Guarantees sub-10ms auto-braking, sonar reflex, and PWM motor drive", "Arduino Uno R3", "< 1.0 ms (100 Hz)", "Hardware Watchdog Stop (1000ms)"],
]

table(s5, 0.6, 1.45, 12.14, 4.7, role_table, col_widths=[2.1, 3.4, 2.0, 1.8, 2.84], size=10.5, highlight_row=None)

# Insight box
ins_box = s5.shapes.add_shape(MSO_SHAPE.ROUNDED_RECTANGLE, Inches(0.6), Inches(6.25), Inches(12.14), Inches(0.75))
fill(ins_box, CARD2, line=CYAN)
text(s5, 0.85, 6.32, 11.6, 0.6,
     "Architectural Redundancy Principle: High-complexity neural models own predictive obstacle avoidance, "
     "while lightweight deterministic algorithms (Laplacian CV & Arduino Sonar FSM) guarantee failsafe survivability.",
     11.5, TEXT, anchor=MSO_ANCHOR.MIDDLE)


# =====================================================================
# SLIDE 6 — SCREENSHOTS OF INPUTS
# Guideline 5: Screen shots of inputs
# =====================================================================
s6 = new_slide("Screenshots of Inputs — Raw Sensor and Video Data",
               "Unprocessed RGB camera frames and roadway test imagery ingested by the perception layer",
               notes="Explain input resolutions, camera hardware, and real Indian road surface challenges.")

image_card(s6, 0.6, 1.45, 6.8, 5.35, "screenshot_input_raw.jpg",
           "INPUT 1: Raw Roadway Camera Feed (pothole_test_2.mp4)",
           "CSI Camera capture at 640×480 @ 30 FPS under natural ambient daylight; shows road depression and cavity.")

card(s6, 7.6, 1.45, 5.14, 5.35, "Input Specification & Preprocessing", [
    ("Sensor Hardware:", "Raspberry Pi Camera Module (OmniVision OV5647) via 2-lane MIPI CSI-2 bus."),
    ("Raw Resolution:", "640 × 480 pixels @ 30 FPS (uncompressed RGB888 format)."),
    ("AWB Tuning:", "Custom Daylight AWB profile calibrated to eliminate fluorescent lab color shifts."),
    ("Preprocessing Pipeline:", [
        "1. Dynamic ROI cropping: lower 55% of frame (eliminates sky/background noise).",
        "2. Bilinear resize to 320 × 320 pixels for high-throughput NCNN neural ingest.",
        "3. FP16 float conversion and channel normalization (mean=[0,0,0], std=[255,255,255]).",
    ]),
    ("Challenging Attributes:", "Variable Indian road textures, uneven sunlight patches, shadows, and low cavity edge contrast."),
], accent=CYAN, title_size=15, body_size=11)


# =====================================================================
# SLIDE 7 — SCREENSHOTS OF INTERMEDIATE OUTPUTS
# Guideline 6: Screen shots of intermediate output, if any
# =====================================================================
s7 = new_slide("Screenshots of Intermediate Outputs",
               "Internal mathematical representations: Edge maps, morphological masks, and corridor zone costs",
               notes="Show the intermediate Laplacian edge map, morphological dilation/closing, and 3-zone corridor cost.")

image_card(s7, 0.6, 1.45, 6.8, 5.35, "screenshot_intermediate_edges.jpg",
           "INTERMEDIATE 1: Laplacian Gradients & Corridor Zone Grid",
           "Lower 55% ROI processed via ∇²f edge detector + 13×13 elliptical closing + Left/Center/Right zone risk partition.")

card(s7, 7.6, 1.45, 5.14, 2.6, "Intermediate Transformation Stages", [
    ("Stage 1 — ROI Isolation:", "Discards upper 45% of frame, focusing compute purely on the drivable road floor."),
    ("Stage 2 — Gaussian Smoothing:", "5×5 kernel reduces high-frequency road gravel noise: G(x,y) * I(x,y)."),
    ("Stage 3 — Spatial Laplacian:", "Extracts abrupt cavity boundaries: ∇²I = ∂²I/∂x² + ∂²I/∂y²."),
    ("Stage 4 — Morphological Close:", "13×13 elliptical structuring element fuses fragmented edges into closed cavity contours."),
], accent=VIOLET, title_size=14, body_size=10.5)

card(s7, 7.6, 4.15, 5.14, 2.65, "Corridor Risk Scoring Engine", [
    ("Zone Splitting:", "Image partitioned into Left (0–33%), Center (33–66%), and Right (66–100%) corridors."),
    ("Danger Formulation:", "Score_z = Σ [ conf_i · W_type · (0.4 + min(Area_i / Area_z, 0.5)) ]."),
    ("Weight Multipliers:", "W_obstacle = 1.0  |  W_pothole = 1.5–2.0 (elevated hazard penalty)."),
    ("Intermediate Decision:", "Center cost: 0.88 (BLOCKED) → Left cost: 0.12 (CLEAR) → Issue Swerve Vector."),
], accent=AMBER, title_size=14, body_size=10.5)


# =====================================================================
# SLIDE 8 — SCREENSHOTS OF FINAL OUTPUTS (DETECTION & SWERVE)
# Guideline 7: Screen shots of output
# =====================================================================
s8 = new_slide("Screenshots of Final Outputs — Pothole & Obstacle Avoidance",
               "Bounding box detections, corridor hazard classification, and real-time swerve actuation vectors",
               notes="Explain the detected pothole bounding box, corridor swerve arrows, and live perception HUD.")

image_card(s8, 0.6, 1.45, 5.9, 5.35, "slide07_pothole_corridor_frame.jpg",
           "OUTPUT 1: Real Pothole D40 Detection & Swerve Vector",
           "YOLOv10n D40 cavity detected in center lane (Conf: 0.68) → Generates immediate << SWERVE LEFT >> actuation vector.")

image_card(s8, 6.84, 1.45, 5.9, 5.35, "slide12_yolov10n_live_hud.jpg",
           "OUTPUT 2: Live Perception HUD & Latency Telemetry",
           "Live evaluation overlay showing bounding boxes, class counts, 22.4ms latency counter, and 31.6 FPS throughput.")


# =====================================================================
# SLIDE 9 — SCREENSHOTS OF TRACKING & TELEMETRY OUTPUTS
# Guideline 7 (cont): Screen shots of output (Follow-Me & Arduino Telemetry)
# =====================================================================
s9 = new_slide("Screenshots of Final Outputs — Follow-Me & Telemetry",
               "Visual servoing target lock, HSV upper-torso re-identification, and Arduino reflex telemetry logs",
               notes="Show person tracking, upper torso color histogram match, and 115200 baud serial monitor output.")

image_card(s9, 0.6, 1.45, 5.9, 5.35, "slide08_follow_me_tracking_reid.jpg",
           "OUTPUT 3: Follow-Me Target Lock & Re-ID Servo",
           "KCF person box (Green) + Upper Torso Re-ID (0.89 Match) + Standoff target crosshair driving PID steering.")

image_card(s9, 6.84, 1.45, 5.9, 5.35, "slide09_serial_monitor_log.png",
           "OUTPUT 4: Arduino 115200 Baud Real-Time Telemetry",
           "Firmware serial log verifying Tier 2 ultrasonic reflex triggers, distance telemetry, and Tier 1 PI_STOP latches.")


# =====================================================================
# SLIDE 10 — PERFORMANCE BENCHMARKS
# Guideline 8: Performance
# =====================================================================
s10 = new_slide("System Performance Benchmarks & Empirical Evaluation",
                "Rigorous hardware measurements on Raspberry Pi 5 across multiple runtimes, resolutions, and thermals",
                notes="Compare PyTorch vs ONNX vs NCNN vs OpenVINO. Highlight 31.6 FPS and 52.7 deg thermal stability.")

# Runtime Benchmark Table
text(s10, 0.6, 1.42, 6.0, 0.35, "Edge Runtime Latency & Throughput (320×320, Pi 5 CPU)", 12.5, CYAN, bold=True)
run_table = [
    ["Runtime Format", "Precision", "Avg Latency", "Median", "FPS", "NMS Cost"],
    ["PyTorch (LibTorch)", "FP32", "148.2 ms", "146.0 ms", "6.7 FPS", "Included"],
    ["ONNX Runtime", "FP32", "64.8 ms", "63.5 ms", "15.4 FPS", "0.0 ms (NMS-free)"],
    ["Tencent NCNN (Ours)", "FP16", "22.4 ms", "22.1 ms", "31.6 FPS", "0.0 ms (ARM NEON)"],
    ["Intel OpenVINO", "FP16", "38.5 ms", "37.9 ms", "26.0 FPS", "0.0 ms"],
]
table(s10, 0.6, 1.8, 6.2, 2.1, run_table, col_widths=[1.7, 0.8, 1.0, 0.9, 0.8, 1.0], size=10, highlight_row=3)

# Resolution Sweep Table
text(s10, 0.6, 4.05, 6.0, 0.35, "Input Resolution Sweep (NCNN FP16 on Cortex-A76)", 12.5, CYAN, bold=True)
res_table = [
    ["Resolution", "GFLOPs", "Inference Latency", "Throughput", "Suitability"],
    ["640 × 640", "6.7", "72.4 ms", "13.8 FPS", "Stationary / Far vision"],
    ["480 × 480", "3.8", "41.6 ms", "24.0 FPS", "Balanced edge mode"],
    ["320 × 320", "1.7", "22.4 ms", "31.6 FPS", "Real-Time Control Loop"],
]
table(s10, 0.6, 4.42, 6.2, 1.8, res_table, col_widths=[1.3, 0.9, 1.4, 1.1, 1.5], size=10, highlight_row=3)

# Embedded Training Curves
image_card(s10, 7.1, 1.45, 5.6, 4.75, "slide07_pothole_training_curves.png",
           "RDD2022 Pothole Model Training Curves (50 Epochs)",
           "Precision: 54.0%, Recall: 28.5%, mAP@50: 25.2% on challenging Indian road cavity subset.")

# Thermal & Hardware specs footer
therm_box = s10.shapes.add_shape(MSO_SHAPE.ROUNDED_RECTANGLE, Inches(0.6), Inches(6.35), Inches(12.14), Inches(0.68))
fill(therm_box, CARD2, line=GREEN)
text(s10, 0.85, 6.4, 11.6, 0.55,
     "Thermal & Power Stability: Pi 5 sustained 52.7°C steady-state under continuous dual-model inference (Active Cooler). "
     "RAM Footprint: < 340 MB total runtime memory. Arduino loop execution frequency: 100 Hz (10.0 ms tick).",
     11, TEXT, anchor=MSO_ANCHOR.MIDDLE)


# =====================================================================
# SLIDE 11 — CONTRIBUTIONS BEYOND LITERATURE
# Guideline 9: Contribution: Revisions which are not available in literature
# =====================================================================
s11 = new_slide("Contribution: Novel Revisions Not Available in Literature",
                "Key algorithmic, architectural, and hardware innovations developed specifically in this project",
                notes="Detail the 5 core revisions beyond literature: zero-NMS edge CPU, acoustic blindness solution, 3-tier FSM, etc.")

card(s11, 0.6, 1.45, 5.9, 2.65, "01  NMS-Free Edge CPU Inference Pipeline", [
    ("Literature Void:", "Existing literature relies on heavy GPU edge boards (Jetson) or offloads NMS to slow host CPUs."),
    ("Our Revision:", "First implementation coupling dual-label assigned YOLOv10n with Tencent NCNN ARM NEON SIMD vectorization on Raspberry Pi 5 CPU."),
    ("Empirical Result:", "Eliminates the O(N²) candidate suppression overhead, achieving sustained 31.6 FPS without external hardware accelerators."),
], accent=CYAN, title_size=13.5, body_size=10.5)

card(s11, 6.84, 1.45, 5.9, 2.65, "02  Dual-Modality Negative Obstacle Sensing", [
    ("Literature Void:", "Robotics platforms (JetBot, OpenBot, DeepRacer) use ultrasonics/LiDAR, which are acoustically blind to potholes and drop-offs."),
    ("Our Revision:", "Novel fusion combining a fine-tuned RDD2022 D40 neural detector with a sub-4ms classical Laplacian gradient morphology fallback."),
    ("Empirical Result:", "Guarantees zero negative-obstacle blind spots, penalizing cavity corridors by 1.5×–2.0× in the navigation arbiter."),
], accent=AMBER, title_size=13.5, body_size=10.5)

card(s11, 0.6, 4.25, 5.9, 2.7, "03  Heterogeneous 3-Tier Priority Reflex FSM", [
    ("Literature Void:", "Most academic vehicles collapse vision and motor PWM into a single Linux thread, causing motor stutter and braking crashes."),
    ("Our Revision:", "Hardware-decoupled Arduino ATmega328P firmware executing a strict 3-tier priority state machine independent of Linux OS scheduling."),
    ("Empirical Result:", "Tier 1 emergency stop latches instantly; Tier 2 local ultrasonic reflex halts in <10ms; Tier 3 executes Pi velocity commands."),
], accent=GREEN, title_size=13.5, body_size=10.5)

card(s11, 6.84, 4.25, 5.9, 2.7, "04  Software Calibration on Lab Hardware", [
    ("Literature Void:", "Commercial platforms assume identical custom motors and zero wiring restrictions; standard textbooks advise rewiring/desoldering."),
    ("Our Revision:", "Non-destructive software polarity inversion and L298N BJT V_ce(sat) voltage-drop compensation (190–210 PWM floor) for borrowed hardware."),
    ("Empirical Result:", "Preserves fragile 15/60-day college lab component integrity while delivering perfectly balanced, straight-line skid-steering."),
], accent=VIOLET, title_size=13.5, body_size=10.5)


# =====================================================================
# SLIDE 12 — COMPARATIVE PLATFORM BENCHMARK
# =====================================================================
s12 = new_slide("Comparative Platform Benchmark Matrix",
                "Benchmarking our two-layer vehicle against commercial and academic autonomous robotics platforms",
                notes="Highlight how our car outperforms JetBot and OpenBot in latency, negative obstacles, and cost.")

comp_table = [
    ["Platform", "Compute Board", "Primary Vision Model", "NMS Step", "Pothole Sensing", "Reflex Latency", "Est. Cost (INR)"],
    ["Our Vehicle", "Pi 5 (8GB) + Uno R3", "YOLOv10n (NCNN FP16)", "None (0 ms)", "Yes (Dual-Path)", "< 10 ms (Hardware)", "₹7,800"],
    ["NVIDIA JetBot", "Jetson Nano (4GB)", "SSD-MobileNetV2", "Yes (CPU sort)", "No (Blind)", "60–100 ms (OS jitter)", "₹28,500"],
    ["AWS DeepRacer", "Intel Atom CPU", "PPO Policy CNN", "N/A (RL map)", "No (Track only)", "40–70 ms", "₹42,000"],
    ["Duckietown DB21", "Jetson Nano 2GB", "Classical Lane Line CV", "N/A", "No (Tape lines)", "50–80 ms", "₹22,000"],
    ["Intel OpenBot", "Smartphone + Nano", "MobileNet-SSD", "Yes (Android)", "No (Sonar only)", "30–50 ms", "₹12,000+ Phone"],
    ["Hiwonder MentorPi", "Pi 5 (4GB) + STM32", "YOLOv5s (PyTorch)", "Yes (Slow NMS)", "No (2D LiDAR only)", "35–60 ms", "₹36,000"],
]

table(s12, 0.6, 1.45, 12.14, 4.7, comp_table, col_widths=[2.1, 2.1, 2.3, 1.4, 1.6, 1.5, 1.14], size=10.5, highlight_row=1)

comp_box = s12.shapes.add_shape(MSO_SHAPE.ROUNDED_RECTANGLE, Inches(0.6), Inches(6.25), Inches(12.14), Inches(0.75))
fill(comp_box, CARD2, line=CYAN)
text(s12, 0.85, 6.32, 11.6, 0.6,
     "Key Takeaway: Our two-layer architecture achieves superior real-time inference throughput (31.6 FPS) and unique "
     "pothole awareness at less than one-third the cost of imported commercial alternatives.",
     11.5, TEXT, anchor=MSO_ANCHOR.MIDDLE)


# =====================================================================
# SLIDE 13 — SUMMARY, CONCLUSION & FUTURE WORK
# =====================================================================
s13 = new_slide("Summary, Conclusions & Future Roadmap",
                "Key achievements of the capstone project and strategic future engineering roadmap",
                notes="Summarize achievements and explain the 3 planned roadmap extensions: lane tracking, traffic signs, IMU.")

card(s13, 0.6, 1.45, 3.9, 4.6, "01  Verified Achievements", [
    ("Real-Time Autonomy:", "Sustained 31.6 FPS NMS-free YOLOv10n inference on Raspberry Pi 5 CPU."),
    ("Pothole Avoidance:", "Dual-path engine successfully identifies road cavities and executes directional swerving."),
    ("Reflex Safety:", "3-Tier Arduino firmware eliminates Linux PWM jitter and guarantees <10ms auto-braking."),
    ("Follow-Me Tracking:", "KCF + 2D HSV torso Re-ID recovers owner lock after complete occlusion."),
], accent=GREEN, title_size=15, body_size=11)

card(s13, 4.72, 1.45, 3.9, 4.6, "02  Immediate Roadmap", [
    ("LAB Lane Following:", "Multi-ROI lane detector in LAB color space; heading error θ = arctan(dx/dy) fed to PID."),
    ("Traffic Sign Module:", "6-class YOLO classifier (Go, Stop, Red, Green, Speed, Crosswalk) with 5-frame debounce."),
    ("IMU Dead-Reckoning:", "ICM-20948 9-axis sensor fusion over I2C to calculate yaw drift and turn angles."),
], accent=CYAN, title_size=15, body_size=11)

card(s13, 8.84, 1.45, 3.9, 4.6, "03  Hardware Evolution", [
    ("Nano Migration:", "Drop-in swap to Arduino Nano for identical ATmega328P execution in 1/4th chassis footprint."),
    ("MOSFET Motor Driver:", "Replace L298N with TB6612FNG driver to eliminate 2.0V BJT transistor saturation drop."),
    ("Dual Front Sonar:", "Left/Right sonar triangulation to measure obstacle distance and width simultaneously."),
], accent=AMBER, title_size=15, body_size=11)

text(s13, 0.6, 6.3, 12.0, 0.5,
     "Academic Conclusion: Successfully proven that high-level computer vision and low-level deterministic motor control "
     "must be physically decoupled to achieve safe autonomous navigation in developing road environments.",
     11.5, MUTED, italic=True)


# =====================================================================
# SLIDE 14 — CONCLUSION & Q&A
# =====================================================================
s14 = new_slide()
glow14 = s14.shapes.add_shape(MSO_SHAPE.OVAL, Inches(3.6), Inches(1.0), Inches(6.0), Inches(5.5))
fill(glow14, RGBColor(0x0C, 0x22, 0x36))

text(s14, 0, 2.0, 13.333, 1.0, "Thank You", 52, TEXT, bold=True, align=PP_ALIGN.CENTER)
text(s14, 0, 3.1, 13.333, 0.5, "Questions & Discussion", 22, CYAN, align=PP_ALIGN.CENTER)

text(s14, 0, 4.1, 13.333, 0.45, "Krishna Menon (I028)   •   Aditya Rana (I045)   •   Parth Surve (I062)", 16, TEXT, bold=True, align=PP_ALIGN.CENTER)
text(s14, 0, 4.65, 13.333, 0.4, "Computer Vision Mini Project  •  Department of EXTC / CE", 13.5, MUTED, align=PP_ALIGN.CENTER)
text(s14, 0, 5.1, 13.333, 0.4, "NMIMS Mukesh Patel School of Technology Management & Engineering", 13.5, MUTED, align=PP_ALIGN.CENTER)

# ---------------- SAVE PRESENTATIONS ----------------
os.makedirs(OUT_DOCS, exist_ok=True)
dest_primary = os.path.join(OUT_ROOT, FILE_PRIMARY)
dest_docs_primary = os.path.join(OUT_DOCS, FILE_PRIMARY)
dest_sample = os.path.join(OUT_ROOT, FILE_SAMPLE)
dest_docs_sample = os.path.join(OUT_DOCS, FILE_SAMPLE)

prs.save(dest_primary)
shutil.copy(dest_primary, dest_docs_primary)
shutil.copy(dest_primary, dest_sample)
shutil.copy(dest_primary, dest_docs_sample)

print(f"Successfully generated presentation with {len(prs.slides)} slides:")
print(f"  -> {dest_primary}")
print(f"  -> {dest_docs_primary}")
print(f"  -> {dest_sample}")
print(f"  -> {dest_docs_sample}")
