menonkrishna57/model-car-capstone/tests/test_comprehensive_avoidance.py

"""
test_comprehensive_avoidance.py — Tests for Progressive Avoidance, Sensor Fusion, and Remote Control
=====================================================================================================
Verifies:
  1. Fused Zone Scoring (Camera Bounding Box ground-plane proximity + Ultrasonic fusion)
  2. Active Steering Avoidance (Pi actively steers around camera obstacles instead of stopping dead)
  3. Auto-Unstick / Pivot Recovery from PI_STOP latch
  4. Manual Remote Control (Endpoints, D-Pad, speed selection, and collision safety brake)
  5. Rear Ultrasonic Sensor Scaffold (Parsing, telemetry, and reverse safety checks)
"""

import time
import numpy as np
import pytest

from car.main import (
    CommandThrottler,
    SystemState,
    _run_autonomous,
    _check_obstacle_ahead,
    CRUISE_SPEED,
    SLOW_SPEED,
    EMERGENCY_STOP_DISTANCE_CM,
)
from car.perception.avoidance import (
    compute_zone_scores,
    decide_avoidance,
    decide_avoidance_detailed,
)
from car.control.motor_controller import MotorController
from car.perception.sensors import SensorManager
from tests.test_main_coordination import create_mock_motor


# =============================================================================
# 1. Fused Zone Scoring & Proximity Tests
# =============================================================================

def test_compute_zone_scores_with_ground_proximity():
    """Verify that bottom-edge (y2) proximity increases danger score as obstacle nears bumper."""
    frame_w, frame_h = 640, 480

    # Obstacle A: Far away (y2 = 200, top half of frame)
    det_far = [{"bbox": [260, 100, 380, 200], "confidence": 0.8, "class_name": "person"}]
    scores_far = compute_zone_scores(det_far, frame_w, frame_h)

    # Obstacle B: Close to bumper (y2 = 450, bottom of frame)
    det_near = [{"bbox": [260, 250, 380, 450], "confidence": 0.8, "class_name": "person"}]
    scores_near = compute_zone_scores(det_near, frame_w, frame_h)

    assert scores_near["center"] > scores_far["center"], "Obstacle closer to ground bumper must have higher danger"


def test_compute_zone_scores_fuses_ultrasonics():
    """Verify ultrasonic distances fuse into Left/Right danger scores."""
    frame_w, frame_h = 640, 480
    sonar = {"left": 20.0, "right": 85.0, "rear": 999.0}

    # No camera detections, but left ultrasonic is in critical range (< 22cm)
    scores = compute_zone_scores([], frame_w, frame_h, sonar=sonar)

    assert scores["left"] > 1.0, "Critical left ultrasonic must produce strong left danger score"
    assert scores["right"] < 0.1, "Clear right ultrasonic must leave right score low"
    assert decide_avoidance(scores) == "RIGHT", "Must steer RIGHT away from left obstacle"


def test_decide_avoidance_detailed():
    """Verify decide_avoidance_detailed produces nuanced actions and angles."""
    # Obstacle on left -> Veer right
    scores_left = {"left": 0.6, "center": 0.1, "right": 0.05}
    det_right = decide_avoidance_detailed(scores_left)
    assert det_right["action"] == "VEER_RIGHT"
    assert det_right["angle"] > 0

    # Obstacle in center -> Active avoid left
    scores_center = {"left": 0.1, "center": 0.7, "right": 0.4}
    det_center = decide_avoidance_detailed(scores_center)
    assert det_center["action"] == "AVOID_LEFT"
    assert det_center["angle"] < 0


# =============================================================================
# 2. Active Camera Steering Avoidance in _run_autonomous
# =============================================================================

def test_active_camera_steering_avoidance_veers_right():
    """
    Verify that when an obstacle is detected approaching in Center-Left (height ~25%),
    _run_autonomous actively commands TURN right instead of driving straight into it!
    """
    motor, serial_dev = create_mock_motor()
    sensors = SensorManager(motor_controller=motor)
    throttler = CommandThrottler()
    frame = np.zeros((480, 640, 3), dtype=np.uint8)

    # Obstacle on left corridor with height = 120 / 480 = 25% (caution zone)
    # cx = 120 < 0.33 * 640 = 211 -> Left zone danger -> Steer RIGHT
    detections = [{
        "class_name": "person",
        "confidence": 0.85,
        "bbox": [50, 200, 190, 320],
        "type": "positive",
    }]

    pi_latched, action = _run_autonomous(
        motor=motor,
        sensors=sensors,
        detections=detections,
        us_blocked=False,
        frame=frame,
        pi_latched=False,
        motors_enabled=True,
        throttler=throttler,
    )

    # Must NOT freeze in PI_STOP!
    assert pi_latched is False
    # Must actively command TURN right to avoid obstacle
    assert any("TURN 35" in cmd for cmd in serial_dev.written_commands), (
        f"Expected TURN 35 in serial commands, got: {serial_dev.written_commands}"
    )
    assert "AVOIDING" in action or "Steering RIGHT" in action


def test_active_camera_steering_avoidance_veers_left():
    """Verify that when an obstacle is on Right, car actively steers LEFT."""
    motor, serial_dev = create_mock_motor()
    sensors = SensorManager(motor_controller=motor)
    throttler = CommandThrottler()
    frame = np.zeros((480, 640, 3), dtype=np.uint8)

    # Obstacle on right corridor with height = 25%
    detections = [{
        "class_name": "person",
        "confidence": 0.85,
        "bbox": [380, 200, 540, 320],
        "type": "positive",
    }]

    pi_latched, action = _run_autonomous(
        motor=motor,
        sensors=sensors,
        detections=detections,
        us_blocked=False,
        frame=frame,
        pi_latched=False,
        motors_enabled=True,
        throttler=throttler,
    )

    assert pi_latched is False
    assert any("TURN -35" in cmd for cmd in serial_dev.written_commands)
    assert "LEFT" in action


# =============================================================================
# 3. Auto-Unstick / Pivot Recovery from PI_STOP
# =============================================================================

def test_auto_unstick_pivot_escape_when_stationary():
    """
    Verify that when latched in PI_STOP for > 1.2s and an open side exists,
    car unlatches with PI_GO, pivots toward the clear corridor, and escapes!
    """
    motor, serial_dev = create_mock_motor()
    sensors = SensorManager(motor_controller=motor)
    throttler = CommandThrottler()
    frame = np.zeros((480, 640, 3), dtype=np.uint8)

    # Imminent obstacle in center (height = 50%)
    detections = [{
        "class_name": "person",
        "confidence": 0.90,
        "bbox": [200, 100, 440, 340],
        "type": "positive",
    }]

    # Simulate that car was latched 1.5 seconds ago
    throttler.latch_start_time = time.monotonic() - 1.5

    # Right side has ultrasonic clearance
    motor.latest_sonar = {"left": 15.0, "right": 85.0, "rear": 999.0}

    pi_latched, action = _run_autonomous(
        motor=motor,
        sensors=sensors,
        detections=detections,
        us_blocked=False,
        frame=frame,
        pi_latched=True,
        motors_enabled=True,
        throttler=throttler,
    )

    # Latch should be released
    assert pi_latched is False
    assert "PI_GO" in serial_dev.written_commands
    # Pivot escape command should be sent
    assert any("TURN 45" in cmd for cmd in serial_dev.written_commands)
    assert "ESCAPE" in action


# =============================================================================
# 4. Rear Ultrasonic Sensor Scaffold Tests
# =============================================================================
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
