menonkrishna57/model-car-capstone/(commit log)

2026-09-20 feat: wire up full autonomous pipeline (avoidance + follow-me + pothole CV)
    - Move ultrasonic sensors from Pi GPIO to Arduino (fixes jitter under YOLO load)
    - Bump serial baud 9600 -> 115200 for lower latency
    - Add non-blocking sonar polling in Arduino firmware (50ms interval)
    - Integrate Parth's zone-scoring avoidance engine (avoidance.py)
    - Add classical CV pothole detector (Laplacian + morphology, no ML model needed)
    - Add OpenCV KCF person tracker for follow-me mode (tracker.py)
    - Add PID controller for smooth steering (pid.py)
    - Rewrite main.py with priority stack: EMERGENCY STOP > AVOID > FOLLOW
    - Add setup.py for proper package imports
2026-09-21 feat: add Arduino point-to-point control firmware and navigation scenario documentation
2026-09-27 docs: update AGENTS.md to match current architecture
    - 3x ultrasonic sensors -> 2x HC-SR04P (both forward-facing, left/right)
    - Baud rate 9600 -> 115200 throughout
    - Add new modules to repo layout (avoidance.py, tracker.py, pid.py, setup.py)
    - firmware-agent: now owns ultrasonic polling + local avoidance reflex
    - perception-agent: updated for avoidance engine, pothole CV, KCF tracker
    - integration-agent: updated for PID steering + priority stack
    - Section 7: pipeline is wired end-to-end, next steps are hardware testing
2026-09-27 docs: finalize complete architecture in AGENTS.md
    - Update hardware layout to 2x front-facing ultrasonic sensors (instead of 3x)
    - Map out new car/ folder structure (avoidance, tracker, pid, sensors)
    - Document the 3-tier priority stack (Pi Latch > Local Avoidance > Normal Driving)
2026-09-29 System architecture finalized and pin configuration added
2026-09-29 perception: update 2-sensor US parser and owner re-id tracking
2026-09-30 hw: complete ENA/ENB PWM migration — pins.h updated to match new wiring
    - ENA wired to D5, ENB wired to D6 (no longer jumpered to 5V)
    - US1 Trigger moved D5 → D12, US2 Echo moved D6 → D13
    - Copied pins.h and protocol.h into sketch folder for Arduino IDE compatibility
    - Fixed #include paths from ../lib/ to local
2026-10-01 testing both motors with speed
2026-10-07 feat: add live evaluation demo suite, edge benchmarking, and review presentation materials
    - Add demo_live.py with unified YOLOv10n obstacle detection and high-recall pothole avoidance
    - Add dedicated demo_pothole_live.py and demo_yolov10_live.py standalone evaluation scripts
    - Add benchmark.py multi-runtime edge benchmarking suite (PyTorch, NCNN, ONNX, OpenVINO)
    - Update capstone presentation (.pptx) with real training curves, perception HUDs, and YOLOv10n telemetry
    - Reorganize presentation generator tools into tools/presentation/
    - Add slide screenshots to docs/reports/screenshots/ and update .gitignore
2026-10-16 feat: daylight AWB profile, fullscreen stream HUD, and parallel Arduino serial integration
    # Conflicts:
    # arduino/lib/pins.h
    # arduino/motor_test/dual_motor_speed_test.ino
    # arduino/point_to_point_control/pins.h
2026-10-20 Updated the arduino code
2026-10-23 feat: add Arduino point-to-point control firmware and Python live detection script
2026-10-26 feat(cv): enhance pothole detection for images, add presentation materials and output management
2026-10-27 feat(perception): fine-tune pothole model with noise augmentation and add manual obstacle override toggle
    - Augment pothole dataset with synthetic camera-of-photo noise (perspective warp, sensor noise, blur, indoor glare, contrast washout) to detect held road photos
    - Update live_detect.py and car/perception/detector.py to load fine-tuned pothole_best.pt, expand vertical ROI to 12%-98%, and apply CLAHE preprocessing
    - Add manual obstacle override toggle (key 'O', UI button, /toggle_override) in live_detect.py and main.py to bypass ultrasonic auto-braking and camera latches
    - Adjust avoidance.py pothole hazard weight to 1.8 to ensure safe reaction distance
    - Include test suite covering co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
2026-10-27 revert(perception): revert to original RDD2022 pothole model and eliminate false positives
    - Restored original RDD2022 pothole weights in pothole_detection/best.pt, pothole_best.pt, and runs_rdd/custom_pothole_model/weights/best.pt
    - Raised pothole confidence threshold from 0.08 to 0.20-0.22 in config.py and live_detect.py to suppress spurious background triggers
    - Reverted cv_detect_potholes across live_detect.py, detector.py, and run_detection.py to focus strictly on road plane with aspect ratio filtering
    - Removed aggressive CLAHE fallback loops that elevated texture and lighting glare into false positives
    - Preserved manual obstacle override toggle (key 'O', UI button, /toggle_overri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
2026-10-27 feat(perception): fine-tune YOLOv10n pothole model on RTX 3050 GPU for held printout with lower camera ROI filtering
2026-10-29 fix(car): repair control mode latching, manual auto-brake override, and HUD telemetry
2026-10-29 feat(car): repair manual turning, restore camera color filter, and modernize UI cockpit
2026-10-30 feat(control): correct motor direction, startup disarmed state, pi_latch fix, and speed calibration
2026-10-30 feat(control): fix close approach, dual ultrasonic corner recovery, and minimum turn PWM >= 200
2026-10-30 feat(ui): update satin ribbon lane colors and calibration helper
2026-10-30 fix(control): calibrate follow-me distance thresholds and multimodal close proximity check
2026-10-30 feat(ui): default motor polarity to inverted mode on startup
2026-10-30 fix(control): calibrate follow-me steering gain, deadband, and turn burst clamping
    - Map visual pixel error directly to physical camera angle (HFOV 53.5 deg / 640 px = 0.0836 deg/px) and eliminate integral windup (Ki=0)
    - Introduce FollowSteeringStabilizer with deadband (+/-7 deg ~= +/-84px) to allow smooth straight forward driving when target is centered
    - Limit skid-steer turns to safe bursts (max 18 deg) and require reversal confirmation to prevent hunting/thrashing
    - Add Arduino STATE_TURNING and post-turn settling guard to prevent command stacking
    - Prevent derivative kick on first PID update after reset in car/control/pid.py
    - Add reproduction and regression tests verifying deadband, t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
2026-10-30 fix: prevent wall collisions by restoring safe auto-brake, shorten blind reverse to 100ms, and configure Uno avoidance via serial
2026-10-30 fix(lane): resolve undefined us_l_val NameError and return tuple in _run_lane
    - Initialize us_l_val and us_r_val from ultrasonic readings before checking us_blocked
    - Include lane_res in ultrasonic escape return tuples to match 3-tuple contract
    - Add unit test test_run_lane_ultrasonic_blocked_and_escape verifying escape and auto-brake behavior
2026-10-31 feat(perception): limit pothole detection to lower camera section matching live_detect
